ALagrandeur/BOT32/ÉTAT_DU_PROJET.md

# État du projet BOT32

> Photo lisible de l'état du projet. Mise à jour : **2026-10-12**.
> Pour les règles et conventions techniques, voir **`CLAUDE.md`**. Vue d'ensemble
> (matériel, build, utilisation) : **`README.md`** ; UI PC : **`webui/README.md`**.

---

## Version actuelle

**v4.8.1** (principal : v4.8.0 + textes d'aide mis à jour) — dernière version STABLE : **v4.8.0** (validée en voiture le 2026-10-25, release GitHub tag `4.8.0`, point de retour) ; stable précédente : v4.6.0 (tag `v.4.6.0_2_modes`) + **BOT32-HALDEX v3.0.0** (module MITM privé, ESP32-CAN-X2).
**Le X2 de la voiture reste en v3.0.0** (pas de reflash) et **la manette AMOLED n'est pas utilisée** :
seul le principal est flashé, v4.8.0 fonctionne avec ce X2.
Repo public `ALagrandeur/BOT32` (`master`) ; module MITM = dépôt **privé** `BOT32-HALDEX`.
Releases GitHub récentes : **`4.8.0`** (commit `8e49c7f`, 2026-10-25, stable) et `v.4.6.0_2_modes`
(commit `222bdd4`, 2026-10-12).

**Autres appareils liés** : la **manette AMOLED** (dépôt `Remote32`, dossier `Recepteur_AMOLED`,
mode Golf ; **non utilisée actuellement**) parle aussi au X2 par ESP-NOW — elle envoie **SET_MODE seulement** (jamais
SET_PASSTHROUGH). Le X2 a donc deux sources de mode : le principal et la manette.

**Les 3 modes fonctionnent en voiture, confirmés par le pilote.** **STOCK** (normal),
**FWD** (roues avant seulement — le burnout fonctionne), et surtout **50-50 qui TIENT
~95 % d'engagement à TOUTES les vitesses** (le gros morceau enfin résolu). Lien ESP-NOW
solide, contrôle depuis l'UI (modes + passthrough + ack).

### Nouveautés de ce jalon (BOT32-HALDEX v2.0.0 → v3.0.0)
- **50-50 RÉSOLU (le gros morceau).** Découverte clé : le Haldex Gen5 est *feed-forward*
  (piloté par le **couple**, pas le glissement) ET il **réduit l'engagement quand la
  VITESSE monte** — et on lui transmettait la vraie vitesse, donc le lock mourait vers
  60 km/h. Fix : faire croire au Haldex qu'il est **immobile + au ralenti** (vitesse/
  roues/RPM neutralisés côté Haldex) → il ne réduit plus → **95 % tenu à toute vitesse**.
  *(Recette détaillée dans le dépôt privé.)*
- **Angle volant** : seul facteur qui baisse encore le 50-50 — **gardé volontairement**
  (un accouplement 100 % verrouillé bloque la transmission en virage).

### Nouveautés v4.8.1
- Textes d'aide (cellulaire + PC) : l'effacement des codes est un **effacement OBD générique**
  (moteur, et codes antipollution de la boîte DSG) ; « Refus ? Essayer moteur arrêté, contact mis ».
  Aucun autre changement par rapport à la v4.8.0 stable.

### Nouveautés v4.8.0 — 🏁 STABLE (validée en voiture le 2026-10-25)
- **OK maintenu 6 s : plus tolérant + diagnostic.** Premier essai en voiture : rien ne s'est
  déclenché. Un relâchement de moins de 250 ms (trame qui clignote, code qui change) n'annule
  plus l'appui. `/api/status` → `ok_diag` montre ce que BOT32 reçoit pendant l'appui (nombre de
  trames 0x5BF, écart entre trames, durée de l'appui, codes, micro-relâchements, fin du dernier
  maintien : relâché / trame périmée / déclenché).
- **Effacement des codes : OBD générique.** L'envoi direct au moteur (Mode 04 vers 0x7E0, depuis
  v4.6.0) n'effaçait pas les codes dans l'auto. BOT32 envoie maintenant le Mode 04 `[01 04]`
  **OBD générique en adressage fonctionnel sur 0x7DF** (comme un outil OBD générique, sans le mode
  de connexion VW), puis sur **0x700** (adresse de l'outil VW dans `cef.csv`) si le moteur ne
  répond pas. Le moteur décide (0x7E8 : `44` effacé, `78` en attente, autre refus). Comme tout
  effacement OBD générique, la boîte DSG (0x7E9) efface aussi ses codes antipollution ; le message
  l'indique (« Codes effacés : moteur + boîte DSG »).
- **Effacement des codes moteur au volant : bouton OK MAINTENU 6 s** (remplace les 10 appuis
  rapides de v4.7.0). Relâcher avant 6 s annule ; un seul déclenchement par appui (relâcher
  avant le suivant) ; 10 s d'inhibition après un déclenchement. Éviter l'écran des données de
  trajet du combiné : un appui long sur OK les remet à zéro.
- **Haldex remis en STOCK après une longue coupure — par le principal seul, sans reflasher le
  X2.** Le X2 est sur 12 V permanent et sa veille légère garde la mémoire : en v3.0.0 (celui de
  la voiture) le dernier mode survit à une coupure du contact, et **BOT32 est le seul à le
  remettre en STOCK**. Règle (demande du 2026-10-24) :
  - **Coupure de moins de 5 min = mode gardé** : contact coupé puis remis, calage + redémarrage,
    coupure CAN ou radio, redémarrage de BOT32 (chute de tension au démarreur, plantage — BOT32
    reprend alors le mode rapporté par le X2).
  - **Coupure de 5 min ou plus = STOCK.** Coupure = contact OFF (Kl15 lu dans Klemmen_Status_01
    `0x3C0` octet 2 bit 1, confirmé par la capture `1.csv` : `00` → `03` à la mise du contact) ou
    bus cluster silencieux. À 5 min, BOT32 envoie STOCK tout de suite — le X2 est encore éveillé
    (il ne dort qu'après 15 min sans CAN) — et le renvoie à la remise du contact s'il n'a pas été
    confirmé. Seuil : `IGN_LONG_CUT_MS` dans `ignition_watch.h` (5 min ; 10 min possible).
  - **Mise sous tension complète de BOT32** (batterie rebranchée, BOT32 branché) = STOCK : durée de
    coupure inconnue. BOT32 doit être sur alimentation **permanente** (OBD broche 16) pour mesurer la
    coupure ; alimenté par la clé, il donnerait STOCK à chaque démarrage.
  - STOCK est renvoyé toutes les 500 ms **jusqu'à ce que le X2 lui-même le confirme** (normalement
    < 1 s). Si le X2 dort (ESP-NOW coupé), le renvoi continue et le X2 reçoit STOCK environ 1 s
    après son réveil. Abandon seulement après 10 s de liaison sans confirmation, ou 30 min sans
    aucune nouvelle du X2 (absent / pas alimenté).
  - Tous les autres retours en STOCK utilisent le même renvoi confirmé : bouton 🅾 STOCK,
    effacement des codes, TC remis après un combo. Un mode choisi dans l'app ou par combo annule
    le renvoi.
  - Exige la **liaison Haldex activée** dans les réglages de BOT32 (déjà nécessaire pour les combos).
    La désactiver envoie un dernier STOCK confirmé ; ensuite, **plus rien ne remet le X2 en STOCK**
    tant qu'elle reste désactivée. Activée en cours de route (après un démarrage où elle était
    désactivée), la liaison marche tout de suite, sans couper le point d'accès WiFi (avant :
    seulement après un redémarrage de BOT32).
  - Le X2 v3.1.0 (optionnel, non flashé) ajouterait son propre retour en STOCK après 5 s sans CAN,
    ce qui ne respecte pas cette règle : raison de plus pour garder le X2 en v3.0.0.
- **Sortie du combo = le conducteur rallume le TC.** VW rallume le TC tout seul à chaque mise du
  contact : après une courte coupure, le mode combo est gardé et ce TC revenu seul ne le relâche
  pas. Seul un passage TC OFF → ON fait par le conducteur compte (trames TC continues, contact mis,
  tenu 500 ms). Après un redémarrage, pour sortir de FWD/50-50 : **TC OFF puis ON**, ou bouton
  🅾 STOCK. Une trame TC perdue, la coupure du contact ou un redémarrage de l'ESP ne relâchent plus
  le mode (avant : STOCK après 2 s sans trame TC).
- **Combo maintenu malgré une pause de la boucle** (requête web lente, etc.) : la pause fait
  déborder le tampon de réception CAN (32 trames). La fraîcheur des trames du combo se compte en
  temps de lecture CAN (100 ms max par lecture) : une pause ne ressemble jamais à des trames perdues.

### Nouveautés v4.7.0 (déclencheur remplacé en v4.8.0 par « OK maintenu 6 s »)
- **Effacement des codes moteur au volant** : **bouton OK appuyé 10 fois en moins de 6 s**
  (trame MFSW 0x5BF, même décodage que la cellule « OK button » : `byte[0] != 0` = pressé ;
  chaque passage relâché → pressé compte, un appui maintenu compte une fois ; 10 s
  d'inhibition après un déclenchement). Lance exactement la même procédure que le bouton web
  (écoute seule, Haldex STOCK, moteur seulement).
- **Bandeau sur la page principale du cellulaire** (⏳ / ✓ / ✗ + source) seulement si la page
  est ouverte au moment de l'effacement. L'UI PC affiche aussi le résultat, quelle que soit la source.
- Aide-mémoire (cellulaire + PC) : carte « Effacer les codes moteur — OK × 10 en moins de 6 s ».
- ⚠ Le décodage du bouton OK ne distingue pas encore le OK des autres boutons du volant
  (tout `byte[0] != 0` compte). À surveiller ; le code du dernier appui est exposé dans le
  status série (`ok_last_code`) pour l'affiner au besoin.

### Nouveautés v4.6.0
- **Effacement des codes MOTEUR seulement** (bouton web PC + mobile) : BOT32 passe en
  **écoute seule** (aucune émission CAN : ni override du cluster, ni polling OBD), le
  Haldex est remis en **STOCK**, puis Mode 04 est envoyé **au moteur seulement**
  (0x7E0). Le résultat (effacé / refusé / pas de réponse) s'affiche sur la page.
- **50-50 par combinaison** : frein à main tiré + Hazard ON + TC OFF (frein baissé = FWD).
  Un mode armé par le combo ne change plus tant que le TC reste OFF ; TC ON = STOCK.
- **Aide-mémoire des combinaisons** dans l'UI mobile et PC.
- Bouton « Armer / Désarmer le X2 » de la page Réglages mobile réparé (cassé depuis v4.2.0).
- Ancien déclencheur auto Hazard ×3 (jamais codé) retiré de l'UI PC.

### Ajouts principal v4.0.0 → v4.5.0
- **v4.2.0 — Temp embrayage Haldex** : DID UDS **0x2BF1** (poll via le Haldex, à travers
  le pont X2) affichée dans l'UI mobile à la place de « Dernier paquet ». Statut **armé**
  déplacé dans un badge d'en-tête 🟢/🔴 (carte Passthrough retirée ; bouton d'armement
  dans « Tous les réglages »).
- **v4.4.0 — Ménage menu réglages (mobile)** : retiré Cluster bus IDs + Bench test ;
  OBD2 réduit à « Poll Hz » ; « TX » → « Diffusion TX » ; Clear Engine Fault = bouton seul.
- **Voyant shift-lock (0x394) abandonné** : émis par le Gateway + porte le rapport P/R/N/D
  → l'injection parallèle le ferait clignoter / glitcherait l'affichage du rapport. Mode dans l'app.
- **v4.5.0 (FINALE) — Temp embrayage : AFFICHAGE SEULEMENT.** Formule calibrée vs VCDS :
  **`temp_C = data[5]×2.7 − 241.5`** (100→28.5 °C, 104→39.3 °C). **Aucune sécurité/seuil
  côté BOT32** : la **protection thermique native du Haldex** suffit. Le cut-out auto-STOCK
  (ancien v4.3.0) et le raw de calibration (v4.4.0) ont été **retirés** — code épuré.

---

## Module MITM Haldex (BOT32-HALDEX, ESP32-CAN-X2) — résumé technique

- **Topologie en série** : coupe le stub CAN du calculateur Haldex. CAN1 = TWAI natif
  (côté CAR/PCM, GPIO7/6) ; CAN2 = MCP2515 sur HSPI (côté Haldex).
- **Pont CAR ↔ Haldex** dans une **tâche FreeRTOS dédiée** démarrée AVANT le WiFi →
  écart de boot minimal (évite les défauts TC/TPMS au démarrage en série).
- **CRC E2E AUTOSAR** (poly 0x2F, init 0xFF, xorout 0xFF) sur `[D2..D8, DataID]` —
  **DataID APPENDÉ** (confirmé 100 % sur 5 logs réels). Compteur = `D2 & 0x0F`.
- **Réécriture des trames** (FWD inchangé, ça marche) : **FWD** → demande 0x00 + roues
  à 0. **50-50** → épingle le couple + plafond ET fait croire au Haldex qu'il est
  **immobile + au ralenti** (vitesse/roues/RPM neutralisés côté Haldex) pour qu'il ne
  réduise pas l'engagement à vitesse. Le **frein n'est PAS simulé** (freiner-en-roulant
  = 0 % d'engagement, le simuler tuerait le lock). *(Valeurs exactes + table CRC : privé.)*
- **État live lu** : engagement pompe (0x118 D3), pédale (0x121 D3), vitesse (0x0FD).
- **12 V permanent + light-sleep** (15 min d'inactivité CAN) + **wake-on-CAN** ;
  **ne dort jamais** tant qu'un hôte USB est branché (`if (Serial)`).
- **Robustesse CAN** : récupération bus-off TWAI **et** MCP2515 (re-init sur EFLG TXBO),
  exposition du **TEC**. Terminaison **TERM2 (120 Ω)** activée côté Haldex.
- **Persistance** : le passthrough est **persisté en NVS** ; le **mode boot TOUJOURS STOCK**
  (sécurité — rien ne s'active tout seul au démarrage du X2). ⚠ Le X2 ne redémarre pas avec
  l'auto (12 V permanent, la veille garde la RAM) : en v3.0.0 le mode survit à un cycle de
  contact ; c'est BOT32 v4.8.0 (liaison Haldex activée) qui le remet en STOCK après une coupure de 5 min ou plus.

---

## Haldex — logique côté principal

- **Lien ESP-NOW uniquement.** AP téléphone + ESP-NOW **coexistent** sur le **canal 1**
  (mode AP+STA quand le lien est activé). Le PC en **USB-C** peut aussi parler
  directement au X2 (dev/diagnostic) — ESP-NOW court-circuité dans ce mode.
- **2e source de mode : la manette AMOLED** (Remote32, mode Golf ; non utilisée actuellement) écoute le STATE et envoie
  SET_MODE (STOCK/FWD/50-50) ; elle ne peut pas armer. Le principal affiche le **mode
  rapporté par le X2** et renvoie toujours un STOCK explicite quand on appuie sur STOCK.
- **3 modes** : STOCK / FWD / 50-50.
- **FWD** = combo **Hazards ON + TC OFF** (ou app) ; **v3.10.0 : sort quand le TC repasse à ON** (plus quand les warnings s'éteignent → on peut couper les Hazards et garder FWD).
  **50-50** = **v4.6.0 : même combo avec le frein à main tiré** au moment où il se complète (frein baissé = FWD) ; un mode armé par le combo sort quand le TC repasse à ON. Aussi par l'app/USB (sort via STOCK). **Pas d'auto-revert. Pas de seuil de pédale.**
- **Passthrough ON/OFF** (commande live, **depuis l'app du principal seulement**) : ON =
  transparent/sûr ; OFF = MITM **armé**. Le X2 **persiste le passthrough en NVS** (il revient
  dans l'état où il a été laissé ; 1er boot = ON) ; c'est le **mode** qui démarre toujours en
  **STOCK**, donc rien n'est modifié tant qu'un mode n'est pas choisi. Affiché en live +
  confirmation modale avant d'armer + **ack** du X2 dans l'UI.
- **LIVE** : Vitesse · Pédale % · Lock target % · Pump % · Mode · Connexion (bandeau) · Passthrough
  · temp embrayage (0x2BF1, UI mobile). La **santé CAN du X2 (rx/tx✗/TEC/EFLG)** n'est **pas** dans le
  paquet STATE ESP-NOW : elle ne s'affiche que dans l'UI PC en mode **USB-C direct au X2**.
  Boutons mode + armement aussi sur l'**UI mobile**.

---

## Ce qui fonctionne (livré)

- ✅ **Boost-on-coolant** : override de Motor_09 (0x647), mapping linéaire MAP→température.
- ✅ **Polling UDS multi-DID** (round-robin 6 slots) : MAP, éthanol, blocage Haldex, huile DSG, EGT, **temp embrayage Haldex (0x2BF1)**.
- ✅ **4 sniffers passifs** (lecture seule) : frein à main, bouton OK volant, Hazard, Traction Control — Hazard + TC + frein à main servent aussi d'entrées aux combos Haldex.
- ✅ **Effacement codes moteur** (v4.6.0) : écoute seule + Haldex STOCK + Mode 04 vers 0x7E0 — bouton web PC + mobile.
- ⚠️ **Clear DTC tous modules** : la machine à états UDS non bloquante (14 ECU) existe dans le
  firmware, mais **seulement comme commande série** `{"cmd":"clear_all_dtcs"}` — **aucun bouton
  UI** (PC ou mobile). Sa liste contient `0x715`, que `docs/future_features.md` désigne comme
  l'Airbag à ne jamais effacer (à confirmer). Fonction héritée — statut à décider.
- ✅ **Bench test mode** + **lamp killer** (cartographie des voyants du combiné).
- ✅ **UI web PC** (Flask + SocketIO) via USB série + **UI mobile** via WiFi AP (PROGMEM).
- ✅ **MITM Haldex confirmé EN VOITURE** : STOCK / FWD (avant seulement) / 50-50, lien
  ESP-NOW solide, contrôle depuis l'UI. Firmware dans le dépôt **privé** `BOT32-HALDEX`
  (carte Autosport Labs **ESP32-CAN-X2**).
- ✅ **Sécurité** : `block_airbag` forcé ON, 5 s sans émission sur le bus combiné au boot (le
  polling UDS sur le bus OBD2, lui, démarre dès le boot avec les réglages par défaut), confirmations modales,
  aucun ID deviné émis par défaut, mode boot TOUJOURS STOCK, série USB toujours active.

---

## Historique des versions (résumé)

### Principal (BOT32)
| Version | Apport principal |
|---|---|
| v2.x | Voir historique antérieur (UDS multi-DID, WiFi AP, sniffers, bench mode) |
| v3.0.0 | Version stable — toutes les fonctions confirmées sur banc |
| v3.1.0 | **Haldex** : lien ESP-NOW, 3 modes, combo FWD, UI PC+mobile, coexistence canal 1 |
| v3.2.0 | Transport CAN mort retiré (ESP-NOW only) |
| v3.3.0 | Mode/passthrough persistés + UI affiche le mode réel du X2 |
| v3.4.0 | Lamp killer (test voyants au banc, trames live depuis l'UI) |
| v3.7.0 | Source de lien Haldex sélectionnable (ESP-NOW / USB-C direct vers le X2) |
| v3.8.0 | **Verrou de canal ESP-NOW explicite** côté principal + compteur RX + bandeau de lien dans l'UI |
| v3.9.0 | **Power-save WiFi OFF** (lien ESP-NOW fiable) + lecture du canal réel |
| v3.10.0 | **FWD sort quand le TC repasse à ON** (plus quand Hazards OFF) — état TC latché |
| **v4.0.0** | 🏁 **Jalon stable** — tout confirmé en voiture (STOCK/FWD/50-50, lien solide, UI complète) |
| v4.1.0 | Libellés des sources CAN sous les cellules Haldex + finitions de l'UI mobile (dernière release GitHub) |
| v4.2.0 | Temp embrayage Haldex (DID 0x2BF1) dans l'UI mobile + badge d'armement 🟢/🔴 |
| v4.3.0 | Limite de temp embrayage + coupure auto vers STOCK (retirée en v4.5.0) |
| v4.4.0 | Ménage de la page Réglages mobile + valeur brute 0x2BF1 pour la calibration |
| **v4.5.0** | 🏁 Temp embrayage **affichage seulement** (formule calibrée vs VCDS), coupure retirée — version stable précédente |
| **v4.6.0** | 🏁 Stable précédente — Effacement codes moteur en écoute seule, 50-50 par combo (frein à main), aide-mémoire — confirmée en voiture (2026-10-12) |
| v4.7.0 | Effacement des codes moteur au volant (OK × 10 en < 6 s) + bandeau de confirmation sur le cellulaire — jamais validée, remplacée par v4.8.0 |
| v4.8.0 | Haldex remis en STOCK après une coupure de 5 min ou plus (coupure plus courte : mode gardé), renvoyé jusqu'à confirmation du X2 — fonctionne avec le X2 v3.0.0, sans reflash (liaison Haldex activée) ; sortie du combo par le conducteur (TC OFF → ON) ; effacement des codes au volant par **OK maintenu 6 s** ; effacement en Mode 04 OBD générique (0x7DF, puis 0x700) — 🏁 **STABLE, validée en voiture (2026-10-25)**, release `4.8.0` |
| v4.8.1 | Textes d'aide : effacement OBD générique (moteur + boîte DSG) |

### Module MITM (BOT32-HALDEX)
| Version | Apport principal |
|---|---|
| v0.3–0.4 | Persistance état + spoof vitesses de roue (FWD) |
| v0.7.x | **CRC E2E corrigé** (DataID appendé) + 0x116=0xAC / 0x106=0x07 + 50-50 demande 0xFA |
| v1.1.0 | Jeu de trames complet (0x116/0x106/0x0B2) sur FWD ET 50-50, sans seuil pédale |
| v1.3.0 | Pont en **tâche FreeRTOS avant WiFi** (fix défauts TC/TPMS au boot) |
| v1.4.x | **12 V permanent** + light-sleep 15 min + wake-on-CAN + récup bus-off MCP/TWAI + TEC |
| v1.5.0 | **Power-save WiFi OFF** + diagnostics ESP-NOW (canal/tx/rxcmd) |
| v1.6.0 | **Fix 50-50** : 0x0A8 en passthrough (D8 = RPM, pas la demande de lock) |
| **v2.0.0** | 🏁 **Jalon stable** — MITM confirmé en voiture (STOCK/FWD/50-50), lien ESP-NOW solide |
| **v3.0.0** | 🏁 **Jalon stable actuel — dans la voiture** — 50-50 tenu ~95 % à toutes les vitesses, confirmé en voiture (détails dans le dépôt privé) |
| v3.1.0 | **Optionnel, non flashé** — STOCK après 5 s sans CAN et avant la veille + correctif du minuteur de veille. Le X2 de la voiture reste en v3.0.0 |

---

## Pistes / roadmap (à faire — captures en attente)

- *(Probablement obsolète depuis X2 v3.0.0, où le 50-50 tient ~95 % à toutes les vitesses — à confirmer.)*
  📌 **Log Haldex 50-50 en roulant** (côté Haldex) : confirmer que l'engagement (0x118)
  tient sous charge, et tester **0x116** haut/bas/off (seul octet ESP incertain). Comparer
  à un run STOCK. → décide s'il faut affiner le 50-50.
- 📌 **Log cluster voyant** : capturer les **2 payloads** (allumé + éteint) d'un témoin pour
  pouvoir le faire clignoter (indicateur FWD au combiné — la trame « éteinte » manquait).
- ✅ **v4.8.0 validée en voiture le 2026-10-25** (« tout semble fonctionnel ») : règle des 5 min, effacement OBD générique, OK maintenu 6 s. Release GitHub `4.8.0`.
- 💡 Web UI pour les boutons du volant (objectif initial du projet).

---

## Notes de reprise

- Lancer Claude Code depuis `C:\Users\AntoineLagrandeur\MK7-cluster` pour recharger la
  **mémoire auto** ; le code principal est dans `C:\Users\AntoineLagrandeur\BOT32`,
  le module MITM dans `C:\Users\AntoineLagrandeur\BOT32-HALDEX`.
- **Réglages Arduino X2** : carte « ESP32S3 Dev Module », **USB CDC On Boot = Enabled**
  (le port USB-C est l'USB natif de l'ESP32-S3 ; sinon le moniteur série reste muet).
- **ESP-NOW** : les deux ESP32 doivent être sur le **canal 1** (verrouillé) et avec le
  **power-save OFF** (fait en v3.9.0 / v1.5.0). Vérif : bandeau vert dans l'UI, ou
  ligne `[5s]` du X2 `espnow ch=1 tx=… rxcmd=…`.
- **Sur banc** : garder le **X2 sur USB-C** (sinon sommeil après 15 min → ESP-NOW coupé).
- **Jalon v4.0.0 / v2.0.0 (2026-06-06)** : version **stable**, tout confirmé en voiture par le
  pilote. Inclut le fix FWD-sort-sur-TC (v3.10.0) et le fix 50-50 0x0A8 (v1.6.0). Prochaines
  étapes = les 2 captures en attente (log Haldex 50-50 + log cluster voyant).
