ALagrandeur/BOT32/Cluster Bench.png

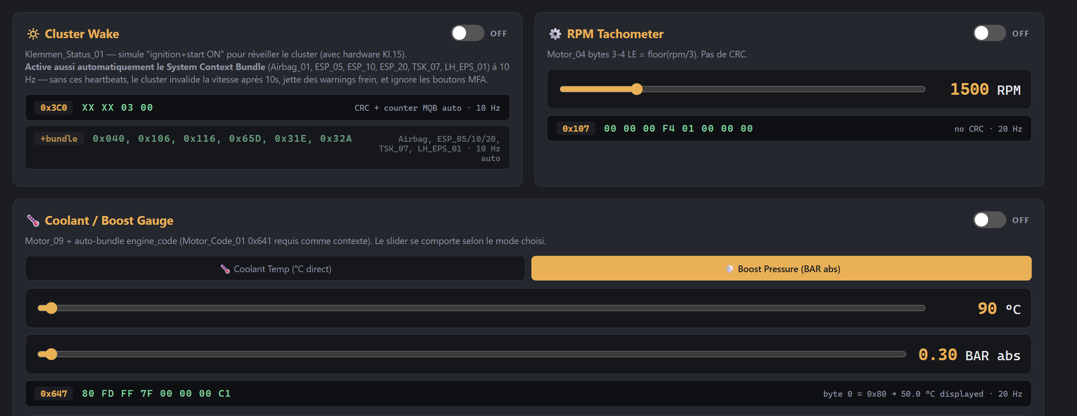
Cluster Bench.png
