ALagrandeur/BOT32/ESP32.jpg

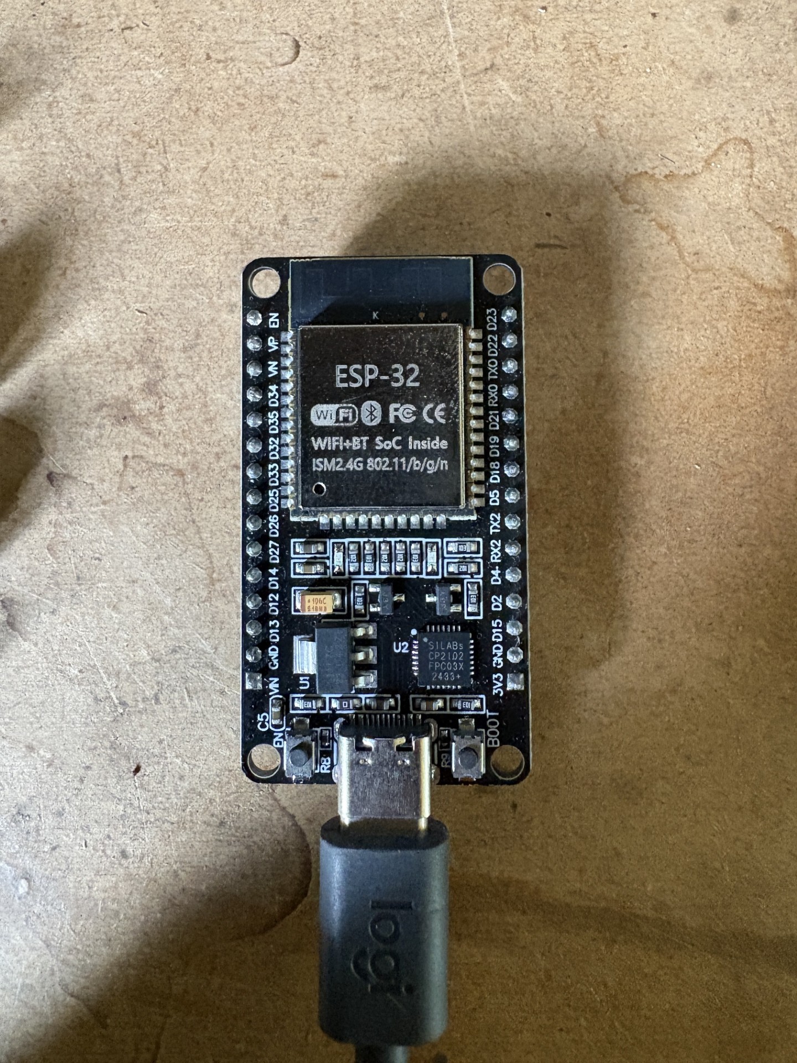
ESP32.jpg
