ALagrandeur/BOT32/HAT.jpg

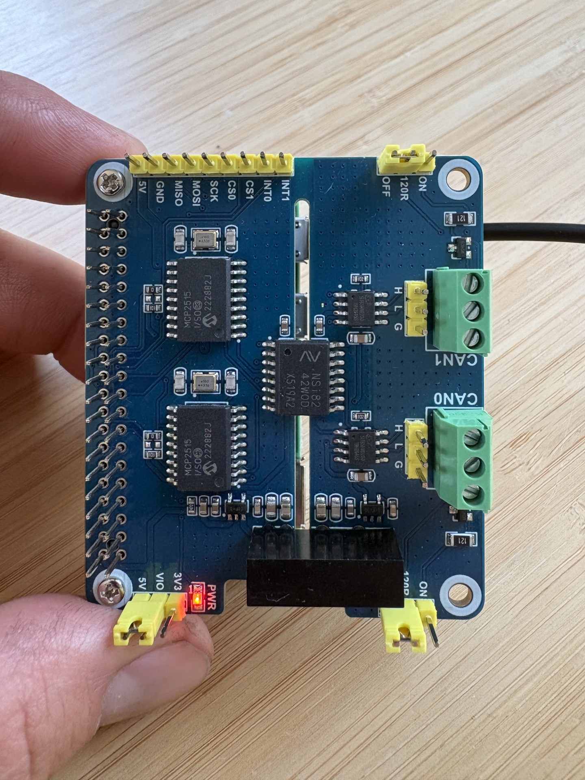
HAT.jpg
