ALagrandeur/BOT32/BOT32/haldex_modes.cpp

/*
 * haldex_modes.cpp — main-side Haldex mode decision logic (v3.1.0).
 *
 * Decides the active mode (STOCK/FWD/5050) from two sources and pushes it to
 * the external MITM (ESP32-CAN-X2) via the ESP-NOW link:
 *
 *   - FWD  : PHYSICAL combo = Hazards ON + Traction-Control OFF, detected via
 *            the existing cluster sniffers. v3.10.0: exits (-> STOCK) when
 *            traction control is turned back ON (NOT when the hazards go off),
 *            so the hazards can be switched off while FWD stays armed. Also
 *            settable from app/USB.
 *   - 5050 : v4.6.0: same combo with the HAND BRAKE PULLED at the moment the
 *            combo completes (else FWD); exits like FWD (TC back ON). Also
 *            app/USB button, which exits via the app/USB STOCK button.
 *   - STOCK: default; app/USB button; or TC-back-ON after a combo FWD.
 *
 * v4.8.0 — a cut shorter than 5 min (key off/on, stall + restart, CAN or radio
 * drop-out, BOT32 reset) keeps the X2 mode; STOCK after a cut of 5 min or more
 * comes from ignition_watch. So a combo mode is only released by the DRIVER
 * turning TC back ON: a TC OFF -> ON change in a continuous TC frame stream,
 * ignition ON, held 500 ms. A lost TC frame, the ignition being cut, or the TC
 * that comes back ON by itself after a restart no longer release it.
 *
 * NOTE on "TC OFF": confirmed on the live data that ESP_21 (0x0FD) byte6 == 0x03
 * is the LATCHED "traction control disabled" state — it stays set after the
 * button is released, and clears (0x00) when TC is re-enabled. So we use it as
 * BOTH the arming gesture (with hazards ON) and the FWD hold/release condition:
 * FWD is held while TC is OFF and released when TC is turned back ON.
 *
 * No timed auto-revert (a timed mechanical revert was judged too dangerous).
 */
#include "haldex_modes.h"
#include "button_sniffer.h"
#include "haldex_link.h"
#include "settings.h"
#include "config.h"
#include "can_handler.h"

#define COMBO_FRESH_MS    2000   // sniffer values older than this are ignored
#define COMBO_POLL_STEP_MS 100   // v4.8.0: max polled time one can_poll() can add
#define TC_ON_CONFIRM_MS   500   // v4.8.0: TC back ON must hold this long to release a combo
#define TC_STREAM_GAP_MS   200   // v4.8.0: no TC frame for this long = stream broken (0x0FD every 20 ms)
#define KL15_FRESH_MS     1000   // v4.8.0: 0x3C0 is sent every 100 ms
#define TELLTALE_BLINK_MS 500    // 0.5 s blink phase while non-STOCK

static uint8_t  g_mode          = HALDEX_M_STOCK;
static bool     g_mode_from_combo = false;  // FWD/50-50 currently held by the combo
static bool     g_prev_combo     = false;   // rising-edge detector
static bool     g_telltale_phase = false;
static uint32_t g_last_blink_ms  = 0;
static bool     g_passthrough_desired = true;  // safe default (X2 boots ON too)
// v4.8.0 — forced STOCK (see haldex_modes_force_stock). The X2 v3.0.0 in the
// car never goes back to STOCK on its own, so STOCK is re-sent until the X2
// itself reports it, including while the X2 sleeps (ESP-NOW down until it wakes).
#define FORCE_STOCK_RESEND_MS    500       // re-send period
#define FORCE_STOCK_WINDOW_MS  10000       // give up after 10 s of X2 link without STOCK
#define FORCE_STOCK_MAX_MS   1800000UL     // ... or 30 min without ever hearing the X2
static bool     g_force_pending   = false;
static bool     g_force_link_off  = false;  // started by switching the link OFF
static uint32_t g_force_start_ms  = 0;
static uint32_t g_force_next_ms   = 0;
static uint32_t g_force_last_ms   = 0;      // last force_stock_tick() time
static uint32_t g_force_online_ms = 0;      // X2 link time since the force started
static bool     g_prev_enabled    = false;  // haldex_enabled at the previous tick
// v4.8.0 — polled time since each combo frame was last seen (see track_frame)
static uint32_t g_prev_poll_ms   = 0;
static uint32_t g_hz_missed_ms   = COMBO_FRESH_MS;
static uint32_t g_tc_missed_ms   = COMBO_FRESH_MS;
static uint32_t g_hb_missed_ms   = COMBO_FRESH_MS;
static uint32_t g_kl_missed_ms   = KL15_FRESH_MS;
// v4.8.0 — combo release by the driver (see header) and resync after a BOT32 reset
static bool     g_tc_seen_off    = false;  // TC seen OFF in the current stream, ignition ON
static bool     g_tc_on_timing   = false;  // TC back ON, confirming
static uint32_t g_tc_on_ms       = 0;
static bool     g_force_confirmed = false; // last forced STOCK was confirmed by the X2
static bool     g_resync         = true;   // adopt the X2 mode once (BOT32 reset, X2 kept its mode)

void haldex_modes_init() {
  g_mode           = HALDEX_M_STOCK;
  g_mode_from_combo = false;
  g_prev_combo     = false;
  g_telltale_phase = false;
  g_last_blink_ms  = 0;
  g_passthrough_desired = true;
  g_force_pending  = false;
  g_force_link_off = false;
  g_prev_enabled   = settings_get().haldex_enabled;
  g_prev_poll_ms   = 0;
  g_hz_missed_ms   = COMBO_FRESH_MS;
  g_tc_missed_ms   = COMBO_FRESH_MS;
  g_hb_missed_ms   = COMBO_FRESH_MS;
  g_kl_missed_ms   = KL15_FRESH_MS;
  g_tc_seen_off    = false;
  g_tc_on_timing   = false;
  g_force_confirmed = false;
  g_resync         = true;
}

// Internal: change mode + forward to the MITM if it actually changed.
static void apply_mode(uint8_t mode) {
  if (mode > HALDEX_M_5050) mode = HALDEX_M_5050;
  if (mode != HALDEX_M_STOCK) g_force_pending = false;   // driver chose a mode
  if (mode == g_mode) return;
  g_mode = mode;
  haldex_link_set_mode(g_mode);   // ESP-NOW SET_MODE to the X2
  Serial.print("[haldex_modes] mode -> ");
  Serial.println(g_mode);
}

// Internal: STOCK now + re-sent by force_stock_tick() until the X2 reports it.
static void force_stock_start(const char* reason, bool link_off) {
  uint32_t now = millis();
  g_mode_from_combo = false;
  apply_mode(HALDEX_M_STOCK);
  haldex_link_send_forced_stock(true);        // always (re)send, even if g_mode was STOCK
  g_force_pending   = true;
  g_force_link_off  = link_off;
  g_force_start_ms  = now;
  g_force_next_ms   = now + FORCE_STOCK_RESEND_MS;
  g_force_last_ms   = now;
  g_force_online_ms = 0;
  g_force_confirmed = false;
  g_resync          = false;
  Serial.print("[haldex_modes] forced STOCK: ");
  Serial.println(reason ? reason : "");
}

bool haldex_modes_set_manual(uint8_t mode) {
  const Settings& s = settings_get();
  if (!s.haldex_enabled) return false;
  if (mode > HALDEX_M_5050) return false;

  // v4.8.0: an explicit STOCK (app, USB, engine-code clear) is always (re)sent
  // and re-sent until the X2 confirms it — the X2 may still be in FWD/50-50
  // while g_mode already reads STOCK (lost broadcast, BOT32 rebooted, USB-C dev link).
  if (mode == HALDEX_M_STOCK) {
    force_stock_start("commande STOCK", false);
    return true;
  }
  // Manual command clears the combo latch so the two sources don't fight.
  g_mode_from_combo = false;
  apply_mode(mode);
  return true;
}

void haldex_modes_force_stock(const char* reason) {
  const Settings& s = settings_get();
  if (!s.haldex_enabled) return;
  force_stock_start(reason, false);
}

bool haldex_modes_force_stock_pending() { return g_force_pending; }
bool haldex_modes_force_stock_confirmed() { return g_force_confirmed; }

// v4.8.0 — combo frames go stale on POLLED time, not wall time. After a long
// stall elsewhere in loop() (e.g. a blocked HTTP request) the 32-frame MCP2515
// RX buffer has overflowed and the first can_poll() may hold no TC frame at
// all; that poll adds at most COMBO_POLL_STEP_MS, so the last decoded value is
// kept until normal polling has missed the frame for COMBO_FRESH_MS. A real bus
// loss (polls continue, no frames) still goes stale after COMBO_FRESH_MS.
static bool seen_at_last_poll(uint32_t age_now) {
  if (age_now == UINT32_MAX) return false;
  int32_t since_poll = (int32_t)(millis() - can_last_poll_ms());
  return age_now <= (since_poll < 0 ? 0u : (uint32_t)since_poll);
}

static void track_frame(uint32_t& missed_ms, uint32_t age_now, uint32_t step) {
  if (seen_at_last_poll(age_now))     missed_ms = 0;
  else if (missed_ms < COMBO_FRESH_MS) missed_ms += step;
}

static void track_combo_frames() {
  uint32_t poll = can_last_poll_ms();
  uint32_t step = 0;
  if (g_prev_poll_ms != 0) {
    int32_t d = (int32_t)(poll - g_prev_poll_ms);
    step = d <= 0 ? 0 : (d > COMBO_POLL_STEP_MS ? COMBO_POLL_STEP_MS : (uint32_t)d);
  }
  g_prev_poll_ms = poll;
  track_frame(g_hz_missed_ms, button_sniffer_hazard_age_ms(),    step);
  track_frame(g_tc_missed_ms, button_sniffer_tc_age_ms(),        step);
  track_frame(g_hb_missed_ms, button_sniffer_handbrake_age_ms(), step);
  track_frame(g_kl_missed_ms, button_sniffer_ignition_age_ms(),  step);
}

// Ignition ON for the TC-release rule (polled time, like the combo frames).
// Klemmen_Status_01 never seen since boot -> assumed ON (no gating possible).
static bool ignition_on_now() {
  if (button_sniffer_ignition_age_ms() == UINT32_MAX) return true;
  return button_sniffer_ignition_on() && g_kl_missed_ms < KL15_FRESH_MS;
}

// True once when the driver turns TC back ON (see header). Tracks the TC OFF
// state in a continuous frame stream with the ignition ON.
static bool tc_turned_back_on(uint32_t now) {
  if (!ignition_on_now() || g_tc_missed_ms >= TC_STREAM_GAP_MS) {
    g_tc_seen_off  = false;              // cut / restart / lost frames: start over
    g_tc_on_timing = false;
    return false;
  }
  if (button_sniffer_tc_pressed()) {     // 0x0FD byte6 == 0x03: TC OFF
    g_tc_seen_off  = true;
    g_tc_on_timing = false;
    return false;
  }
  if (!g_tc_seen_off) return false;      // ON with no OFF seen first (e.g. after a restart)
  if (!g_tc_on_timing) { g_tc_on_timing = true; g_tc_on_ms = now; return false; }
  if ((int32_t)(now - g_tc_on_ms) < (int32_t)TC_ON_CONFIRM_MS) return false;
  g_tc_seen_off  = false;
  g_tc_on_timing = false;
  return true;
}

// After a BOT32 reset that is not a full power-up, the X2 kept its mode: adopt
// it once (first X2 STATE after boot) so the TC / STOCK exits still work. Taken
// as a combo mode, so turning TC OFF then ON again releases it too.
static void resync_from_x2() {
  if (!g_resync) return;
  if (g_force_pending || g_mode != HALDEX_M_STOCK) { g_resync = false; return; }
  HaldexState hx = haldex_link_get_state();
  if (!hx.valid || (uint32_t)(millis() - hx.last_rx_ms) >= HALDEX_LINK_STALE_MS) return;
  g_resync = false;
  if (hx.current_mode == HALDEX_M_STOCK || hx.current_mode > HALDEX_M_5050) return;
  g_mode = hx.current_mode;                // no send: the X2 is already in this mode
  g_mode_from_combo = true;
  Serial.print("[haldex_modes] mode repris du X2 -> ");
  Serial.println(g_mode);
}

static void force_stock_tick(uint32_t now) {
  if (!g_force_pending) return;
  int32_t dt = (int32_t)(now - g_force_last_ms);
  if (dt > 0) g_force_last_ms = now; else dt = 0;
  HaldexState hx = haldex_link_get_state();
  uint32_t age = millis() - hx.last_rx_ms;   // from the snapshot (STATE comes from the WiFi task)
  bool x2_online = hx.valid && age < HALDEX_LINK_STALE_MS;
  if (x2_online) g_force_online_ms += (uint32_t)dt;
  int32_t since = (int32_t)(now - g_force_start_ms);
  // Only a STATE received after the force started proves STOCK: an older one
  // (radio drop-out right after a FWD command) may predate the change.
  if (x2_online && hx.current_mode == HALDEX_M_STOCK &&
      (int32_t)(hx.last_rx_ms - g_force_start_ms) > 0 &&
      since >= (int32_t)FORCE_STOCK_RESEND_MS) {
    g_force_pending   = false;                 // X2 confirmed STOCK
    g_force_confirmed = true;
    Serial.println("[haldex_modes] X2 confirmed STOCK");
    return;
  }
  // Give up: link switched OFF -> 10 s; otherwise 10 s of X2 link without a
  // STOCK report, or 30 min without ever hearing the X2 (missing / unpowered).
  // While the X2 sleeps the re-send keeps going, so it gets STOCK on waking.
  bool give_up = g_force_link_off
      ? since >= (int32_t)FORCE_STOCK_WINDOW_MS
      : (g_force_online_ms >= FORCE_STOCK_WINDOW_MS || since >= (int32_t)FORCE_STOCK_MAX_MS);
  if (give_up) {
    g_force_pending = false;
    Serial.println("[haldex_modes] forced STOCK not confirmed by the X2 - giving up");
    return;
  }
  if ((int32_t)(now - g_force_next_ms) >= 0) {
    haldex_link_send_forced_stock(false);
    g_force_next_ms = now + FORCE_STOCK_RESEND_MS;
  }
}

void haldex_modes_tick(uint32_t now) {
  const Settings& s = settings_get();

  force_stock_tick(now);
  track_combo_frames();

  if (!s.haldex_enabled) {
    // v4.8.0: switching the link OFF sends a last STOCK, re-sent until the X2
    // confirms it (10 s max) — otherwise an X2 v3.0.0 left in FWD / 50-50 would
    // keep that mode at every restart, BOT32 no longer talking to it.
    if (g_prev_enabled) force_stock_start("liaison Haldex desactivee", true);
    g_prev_enabled = false;
    if (!g_force_link_off) g_force_pending = false;
    // Link disabled: force STOCK once and do nothing else.
    if (g_mode != HALDEX_M_STOCK) apply_mode(HALDEX_M_STOCK);
    g_mode_from_combo = false;
    g_prev_combo = false;
    g_telltale_phase = false;
    return;
  }
  g_prev_enabled   = true;
  g_force_link_off = false;   // link back ON: a pending STOCK follows the normal rules

  resync_from_x2();
  bool tc_back_on = tc_turned_back_on(now);

  // ---- Physical combo: Hazards ON + TC OFF (both fresh) ----
  // button_sniffer_tc_pressed() == the LATCHED traction-control-disabled state
  // (0x0FD byte6==0x03 stays set while TC is off), so tc_off is a stable signal.
  bool hazard_on = button_sniffer_hazard_active() && g_hz_missed_ms < COMBO_FRESH_MS;
  bool tc_off    = button_sniffer_tc_pressed()    && g_tc_missed_ms < COMBO_FRESH_MS;
  bool combo     = hazard_on && tc_off;

  // Rising edge of the combo arms FWD, or 50/50 if the hand brake is pulled at
  // that instant (KOMBI_01 0x30B, vehicle-confirmed). Only arms from a
  // non-combo state: once a combo mode is held, re-pressing the hazards (or a
  // stale 0x366 frame coming back) never switches FWD <-> 50/50 while TC is
  // still OFF. To change, turn TC back ON (-> STOCK) and redo the combo.
  // Hazards ON is the deliberate gate, so disabling TC alone never arms anything.
  if (combo && !g_prev_combo && !g_mode_from_combo) {
    bool hb_on = button_sniffer_handbrake_active() && g_hb_missed_ms < COMBO_FRESH_MS;
    g_mode_from_combo = true;
    apply_mode(hb_on ? HALDEX_M_5050 : HALDEX_M_FWD);
  }
  g_prev_combo = combo;

  // v3.10.0: TC turned back ON releases a combo-armed mode (FWD or 50/50) back to STOCK (was
  // "hazards OFF"). So the hazards can be switched off while FWD stays armed;
  // FWD drops only when traction control is re-enabled.
  // v4.8.0: only the driver turning TC back ON counts (tc_turned_back_on): a
  // lost TC frame or a short cut keeps the mode. Re-sent until the X2 confirms.
  if (g_mode_from_combo && tc_back_on) {
    force_stock_start("TC reactive", false);
  }

  // ---- Telltale blink phase (exposed only; no CAN emit here) ----
  if (g_mode == HALDEX_M_STOCK) {
    g_telltale_phase = false;
  } else if (now - g_last_blink_ms >= TELLTALE_BLINK_MS) {
    g_telltale_phase = !g_telltale_phase;
    g_last_blink_ms = now;
  }
}

uint8_t haldex_modes_get()          { return g_mode; }
bool    haldex_modes_telltale_on()  { return g_telltale_phase; }

bool haldex_modes_set_passthrough(bool passthrough) {
  const Settings& s = settings_get();
  if (!s.haldex_enabled) return false;
  bool ok = haldex_link_set_passthrough(passthrough);
  if (ok) g_passthrough_desired = passthrough;
  return ok;
}

bool haldex_modes_get_passthrough_desired() { return g_passthrough_desired; }
