ALagrandeur/BOT32/BOT32/haldex_modes.h

/*
 * haldex_modes.h — BOT32 main-side Haldex mode logic (v3.1.0)
 *
 * This module decides WHICH Haldex mode is active and pushes it to the
 * external MITM device (the ESP32-CAN-X2 running BOT32-HALDEX) via the
 * ESP-NOW link (haldex_link_set_mode).
 *
 * Mode sources (per user spec):
 *   - FWD  : armed by a PHYSICAL combo — Hazards ON + Traction Control OFF
 *            (detected by the existing cluster sniffers), OR by the app/USB
 *            button. v3.10.0: it EXITS (back to STOCK) when Traction Control is
 *            turned back ON (NOT when the hazards go off) — so the hazards can
 *            be switched off while FWD stays armed.
 *   - 5050 : v4.6.0: same physical combo with the HAND BRAKE PULLED when it
 *            completes (else FWD) — exits like FWD (TC back ON). Also the
 *            app/USB button, which EXITS via the app/USB STOCK button.
 *   - STOCK: default; app/USB button.
 *
 * There is NO timed auto-revert (a timed mechanical revert was judged too
 * dangerous). Exit is always an explicit driver action.
 *
 * Telltale feedback: while a non-STOCK mode is active, the user wants the
 * hand-brake telltale to blink on the cluster. NOTE: this car has a MANUAL
 * hand brake whose telltale is driven by a hard-wired switch, NOT by a CAN
 * input frame — so blinking it via CAN is uncertain (bench-only at best).
 * This module therefore only EXPOSES the desired blink state
 * (haldex_modes_telltale_on()); it does NOT emit any guessed CAN frame by
 * default (honours the project safety rule). The actual telltale TX is a
 * separate, to-be-confirmed step (jalon 3).
 */
#ifndef BOT32_HALDEX_MODES_H
#define BOT32_HALDEX_MODES_H

#include <Arduino.h>

// Mode numbers (subset of the documented convention; only 3 are supported).
#define HALDEX_M_STOCK 0
#define HALDEX_M_FWD   1
#define HALDEX_M_5050  2

void    haldex_modes_init();

// Call every loop. Runs the Hazard+TC combo state machine and (re)sends the
// effective mode to the MITM whenever it changes.
void    haldex_modes_tick(uint32_t now);

// Manual mode request from the app / USB (0=STOCK, 1=FWD, 2=5050).
// Clears the physical-combo latch so the two sources don't fight.
// Returns true if the command was accepted + forwarded to the MITM.
bool    haldex_modes_set_manual(uint8_t mode);

// v4.8.0 — force STOCK (vehicle cut for 5 min or more, BOT32 power-up — see
// ignition_watch). Clears the combo latch, sends STOCK now and keeps re-sending it every
// 500 ms until the X2 reports STOCK — also while the X2 sleeps (it gets STOCK
// as soon as it wakes). Gives up after 10 s of X2 link without a STOCK report,
// or 30 min without hearing the X2 at all. Every other STOCK (app/USB button,
// engine-code clear, TC back ON after a combo, link switched OFF) uses the same
// re-send. A mode chosen afterwards from the app or a combo cancels the re-send;
// a mode sent by the AMOLED remote (which BOT32 does not see) is only safe once
// the X2 has confirmed STOCK (normally < 1 s). No-op if Haldex disabled.
void    haldex_modes_force_stock(const char* reason);
bool    haldex_modes_force_stock_pending();
bool    haldex_modes_force_stock_confirmed();   // the last forced STOCK was confirmed by the X2

// Current effective mode (0/1/2) as decided by this module.
uint8_t haldex_modes_get();

// True while the desired telltale-blink phase is "on" (for a future cluster
// TX and for UI indication). Toggles at ~0.5 s while a non-STOCK mode is
// active; always false in STOCK.
bool    haldex_modes_telltale_on();

// v3.2.0 — passthrough control (sent to the X2 over ESP-NOW).
//   passthrough=true  -> X2 is a transparent bridge (safe; nothing modified).
//   passthrough=false -> X2 arms the MITM (FWD/5050 actually force the lock).
// The X2 always BOOTS in passthrough=ON; this is the desired value pushed by
// the user. Returns true if the command was accepted + forwarded.
bool    haldex_modes_set_passthrough(bool passthrough);

// Last passthrough value we COMMANDED (desired). The ACTUAL value reported by
// the X2 comes from the STATE packet (HaldexState.passthrough).
bool    haldex_modes_get_passthrough_desired();

#endif // BOT32_HALDEX_MODES_H
