ALagrandeur/BOT32/BOT32/wifi_ui.cpp

/*
 * wifi_ui.cpp — implementation
 */
#include "wifi_ui.h"
#include "settings.h"
#include "obd2.h"
#include "lever_decoder.h"
#include "coolant.h"
#include "haldex_link.h"
#include "haldex_modes.h"
#include "serial_proto.h"
#include "button_sniffer.h"
#include "ok_clear.h"
#include "config.h"
#include "haldex_espnow.h"
#include <WiFi.h>
#include <esp_wifi.h>
#include <WebServer.h>
#include <ArduinoJson.h>

// =============================================================
//  State
// =============================================================
static WebServer g_server(80);
static bool     g_active   = false;
static String   g_curr_ssid = "";

// Build version is owned by serial_proto; we'll just read SETTINGS_VERSION
// from settings struct for display purposes.

// =============================================================
//  Mobile HTML (served at "/")
//  Kept short + dependency-free so it fits in PROGMEM.
//  Auto-polls /api/status every 500 ms.
// =============================================================
static const char MOBILE_HTML[] PROGMEM = R"HTML(<!DOCTYPE html>
<html lang="fr"><head>
<meta charset="utf-8">
<meta name="viewport" content="width=device-width,initial-scale=1,user-scalable=no">
<title>BOT32 mobile</title>
<style>
  *{box-sizing:border-box;-webkit-tap-highlight-color:transparent}
  body{font-family:-apple-system,Segoe UI,Roboto,sans-serif;background:#1a1a2e;color:#e8e8f0;margin:0;padding:14px;font-size:16px}
  h1{margin:0 0 14px;font-size:22px;color:#7df;display:flex;align-items:center;gap:8px}
  h1 .v{font-size:11px;background:#0a4;padding:2px 7px;border-radius:10px;font-weight:600}
  .grid{display:grid;grid-template-columns:1fr 1fr;gap:10px}
  .card{background:#252540;border-radius:10px;padding:12px;border:1px solid #404060}
  .lbl{font-size:11px;color:#8a8aa0;text-transform:uppercase;letter-spacing:.5px}
  .val{font-size:24px;font-weight:600;margin-top:4px;color:#fff}
  .val.stale{color:#666}
  .can{font-size:10px;color:#666;font-family:monospace;margin-top:2px}
  .actions{margin-top:14px;display:grid;gap:8px}
  button{background:#3a3a5a;color:#fff;border:none;padding:14px;border-radius:10px;font-size:16px;font-weight:600;cursor:pointer;active:bg-#4a4a6a}
  button.danger{background:#a33}
  button.primary{background:#0a4}
  button:active{transform:scale(.98)}
  .status{margin-top:10px;font-size:12px;color:#7af;text-align:center;min-height:18px}
  .conn{position:fixed;top:0;right:0;padding:4px 10px;font-size:10px;background:#0a4;color:#fff;border-radius:0 0 0 8px}
  .clrb{display:none;position:fixed;left:10px;right:10px;top:26px;z-index:9;padding:14px;border-radius:10px;font-size:16px;font-weight:700;text-align:center;color:#fff;box-shadow:0 4px 14px rgba(0,0,0,.5)}
  .conn.off{background:#a33}
  .hx-btns{margin-top:20px;display:flex;gap:8px;justify-content:center;flex-wrap:wrap}
  .hxb{flex:1 1 0;min-width:90px;background:#3a3a5a}
  .hxb.active{outline:2px solid #7df;background:#2a3a6a}
  .card.tap{cursor:pointer}
  .card.armed{border-color:#a33;background:#3a2530}
  .help{margin-top:16px;background:#252540;border:1px solid #404060;border-radius:10px;overflow:hidden}
  .help summary{padding:13px 14px;font-weight:600;color:#7df;cursor:pointer;list-style:none;display:flex;justify-content:space-between}
  .help summary::-webkit-details-marker{display:none}
  .help summary::after{content:'▾';color:#8a8aa0}
  .help[open] summary::after{content:'▴'}
  .combo{padding:11px 14px;border-top:1px solid #404060}
  .combo h3{margin:0 0 7px;font-size:15px;color:#fff;display:flex;align-items:center;gap:8px}
  .k{display:inline-block;background:#3a3a5a;border:1px solid #5a5a80;border-radius:6px;padding:3px 8px;font-size:13px;font-weight:600;white-space:nowrap}
  .plus{color:#8a8aa0;margin:0 4px;font-weight:700}
  .note{font-size:12px;color:#9a9ab0;margin-top:6px;line-height:1.4}
  .warn{padding:10px 14px;border-top:1px solid #404060;font-size:12px;color:#fc8;background:#2e2638;line-height:1.4}
</style></head>
<body>
<div class="conn" id="conn">●</div>
<div class="clrb" id="clrb" onclick="this.style.display='none'"></div>
<h1>BOT32 <span class="v" id="v">—</span></h1>

<div class="grid">
  <div class="card">
    <div class="lbl">Lever</div><div class="val" id="lever">—</div>
    <div class="can">0x394 WBA_03</div>
  </div>
  <div class="card">
    <div class="lbl">MAP mbar</div><div class="val" id="map">—</div>
    <div class="can">DID 0x39C0</div>
  </div>
  <div class="card">
    <div class="lbl">Coolant TX</div><div class="val" id="cool">—</div>
    <div class="can">0x647 Motor_09</div>
  </div>
  <div class="card">
    <div class="lbl">Real coolant</div><div class="val" id="rcool">—</div>
    <div class="can">0x647 RX</div>
  </div>
  <div class="card">
    <div class="lbl">⛽ Ethanol %</div><div class="val" id="eth">—</div>
    <div class="can">DID 0xF452</div>
  </div>
  <div class="card">
    <div class="lbl">🏁 Haldex %</div><div class="val" id="hdx">—</div>
    <div class="can">DID 0x2BF3</div>
  </div>
  <div class="card">
    <div class="lbl">🌡 DSG oil °C</div><div class="val" id="dsg">—</div>
    <div class="can">DID 0x2104</div>
  </div>
  <div class="card">
    <div class="lbl">🔥 EGT °C</div><div class="val" id="egt">—</div>
    <div class="can">DID 0x40D5</div>
  </div>
  <div class="card">
    <div class="lbl">🅿 Hand brake</div><div class="val" id="hbr">—</div>
    <div class="can">0x30B b[2] bit 7</div>
  </div>
  <div class="card">
    <div class="lbl">🅾 OK button</div><div class="val" id="okb">—</div>
    <div class="can">0x5BF b[0]</div>
  </div>
  <div class="card">
    <div class="lbl">⚠ Hazard</div><div class="val" id="hz">—</div>
    <div class="can">0x366 b[2] bit 4</div>
  </div>
  <div class="card">
    <div class="lbl">🚫 TC button</div><div class="val" id="tc">—</div>
    <div class="can">0x0FD b[6]</div>
  </div>
</div>

<h2 style="font-size:14px;color:#7df;margin:16px 0 8px">🏁 Haldex (MITM) <span id="hx-arm" style="font-size:11px;font-weight:700;padding:2px 8px;border-radius:10px;background:#444;color:#fff;vertical-align:middle">—</span></h2>
<div class="grid" id="hx-grid">
  <div class="card"><div class="lbl">Mode</div><div class="val" id="hx-mode">—</div><div class="can">MITM · ESP-NOW</div></div>
  <div class="card"><div class="lbl">Connexion</div><div class="val" id="hx-conn">—</div><div class="can">ESP-NOW</div></div>
  <div class="card"><div class="lbl">Vitesse km/h</div><div class="val" id="hx-spd">—</div><div class="can">0x0FD ESP_21</div></div>
  <div class="card"><div class="lbl">Pédale %</div><div class="val" id="hx-ped">—</div><div class="can">0x121 MOTOR_20 D3</div></div>
  <div class="card"><div class="lbl">Lock target %</div><div class="val" id="hx-tgt">—</div><div class="can">consigne (mode)</div></div>
  <div class="card"><div class="lbl">Pump eng. %</div><div class="val" id="hx-pump">—</div><div class="can">0x118 D3</div></div>
  <div class="card"><div class="lbl">Temp embrayage</div><div class="val" id="hx-temp">—</div><div class="can">0x2BF1 Haldex</div></div>
</div>
<div class="hx-btns">
  <button class="hxb hxb-off" onclick="hmode(0)">🅾 STOCK</button>
  <button class="hxb hxb-fwd" onclick="hmode(1)">🔥 FWD</button>
  <button class="hxb hxb-5050" onclick="hmode(2)">🚀 50/50</button>
</div>

<div class="actions">
  <button onclick="location.href='/settings'">⚙ Tous les réglages</button>
</div>

<details class="help">
  <summary>📖 Aide-mémoire — combinaisons</summary>
  <div class="warn">⚠ Haldex : les modes FWD / 50-50 n'agissent que si le X2 est <b>🔴 ARMÉ</b>. Auto coupée <b>5 min ou plus</b> : retour en <b>STOCK</b> (coupure plus courte : le mode est gardé).</div>
  <div class="combo">
    <h3>🔥 FWD (traction avant)</h3>
    <span class="k">⚠ Hazard ON</span><span class="plus">+</span><span class="k">🚫 TC OFF</span>
    <div class="note">Dans n'importe quel ordre, <b>frein à main baissé</b> (sinon c'est 50/50). Ensuite tu peux éteindre les Hazard : FWD reste actif. Aussi : bouton 🔥 FWD ci-dessus.</div>
  </div>
  <div class="combo">
    <h3>🅾 Retour STOCK</h3>
    <span class="k">🚫 TC ON</span>
    <div class="note">Rallumer le Traction Control (si FWD ou 50/50 a été activé par la combinaison). Après un redémarrage, le TC revient seul à ON sans changer le mode : <b>TC OFF puis ON</b>. Si le mode vient de l'app : bouton 🅾 STOCK.</div>
  </div>
  <div class="combo">
    <h3>🚀 50/50</h3>
    <span class="k">🅿 Frein à main tiré</span><span class="plus">+</span><span class="k">⚠ Hazard ON</span><span class="plus">+</span><span class="k">🚫 TC OFF</span>
    <div class="note">Le frein à main doit être tiré <b>avant</b> de compléter la combinaison (sinon c'est FWD). Ensuite tu peux le relâcher et éteindre les Hazard : 50/50 reste actif. Aussi : bouton 🚀 50/50 ci-dessus.</div>
  </div>
  <div class="combo">
    <h3>🔧 Effacer les codes moteur</h3>
    <span class="k">🅾 OK maintenu</span><span class="plus">pendant</span><span class="k">6 s</span>
    <div class="note">Bouton OK du volant, maintenu enfoncé. Effacement OBD générique (moteur, et codes antipollution de la boîte DSG) : BOT32 passe en écoute seule, le Haldex est remis en STOCK. Message ici si la page est ouverte. Évite l'écran des données de trajet (un appui long les remet à zéro). Aussi : bouton dans ⚙ Tous les réglages.</div>
  </div>
  <div class="combo">
    <h3>📈 Boost sur la jauge de température</h3>
    <span class="k">Levier S</span><span class="plus">ou</span><span class="k">Levier M</span>
    <div class="note">En P / R / N / D, la jauge affiche la vraie température moteur.</div>
  </div>
  <div class="combo">
    <h3>🔓 Armer / désarmer le X2</h3>
    <span class="k">📱 App seulement</span>
    <div class="note">⚙ Tous les réglages → Armement MITM. Le statut 🟢 / 🔴 s'affiche à côté de « Haldex (MITM) ».</div>
  </div>
</details>

<div class="status" id="st">—</div>

<script>
const $ = id => document.getElementById(id);
let lastOk = 0;

async function poll(){
  try{
    const r = await fetch('/api/status',{cache:'no-store'});
    if(!r.ok) throw 0;
    const s = await r.json();
    lastOk = Date.now();
    clrBanner(s);
    $('v').textContent = s.version ? 'v'+s.version : '—';
    $('lever').textContent = (s.lever && s.lever!=='?') ? (s.gear?s.lever+s.gear:s.lever) : '—';
    setVal('map', s.map_mbar>=0 ? Math.round(s.map_mbar) : null);
    setVal('cool', s.coolant_byte!==undefined ? (s.coolant_byte*0.7339-43.94).toFixed(1)+'°' : null, !s.motor09_tx_active);
    setVal('rcool', s.real_coolant_c>=0 ? s.real_coolant_c.toFixed(1)+'°' : null);
    setVal('eth', s.ethanol_pct>=0 ? s.ethanol_pct.toFixed(1)+'%' : null);
    setVal('hdx', s.haldex_blockage_pct>=0 ? s.haldex_blockage_pct.toFixed(1)+'%' : null);
    // v2.8.0 — 3 temps + 2 sniffers (sentinel -1000 = no data for temps)
    setVal('dsg',  (s.dsg_oil_c    !== undefined && s.dsg_oil_c    > -999) ? s.dsg_oil_c.toFixed(0)    + '°' : null);
    setVal('egt',  (s.egt_c        !== undefined && s.egt_c        > -999) ? s.egt_c.toFixed(0)        + '°' : null);
    const hbFresh = (s.handbrake_age_ms !== undefined && s.handbrake_age_ms < 5000);
    setVal('hbr', hbFresh ? (s.handbrake_active ? '✓ ON' : 'OFF') : null);
    const okFresh = (s.ok_button_age_ms !== undefined && s.ok_button_age_ms < 5000);
    setVal('okb', okFresh ? (s.ok_button_pressed ? '✓ PRESS' : 'rel.') : null);
    // v2.9.0 — Hazard + TC sniffers
    const hzFresh = (s.hazard_age_ms !== undefined && s.hazard_age_ms < 5000);
    setVal('hz', hzFresh ? (s.hazard_active ? '✓ ON' : 'OFF') : null);
    const tcFresh = (s.tc_button_age_ms !== undefined && s.tc_button_age_ms < 5000);
    // v2.10.0: bouton tenu = traction control OFF ; relâché = ON (normal)
    setVal('tc', tcFresh ? (s.tc_button_pressed ? 'OFF' : 'ON') : null);
    // v3.1.0 — Haldex (MITM)
    const hx = s.haldex || {};
    const names = ['STOCK','FWD','50/50'];
    const online = !!hx.online;
    // v3.3.0: prefer the mode REPORTED by the X2 (persisted) when online
    const lm = (online && hx.current_mode !== undefined) ? hx.current_mode
             : ((hx.local_mode !== undefined) ? hx.local_mode : 0);
    setVal('hx-mode', names[lm] || '—');
    setVal('hx-conn', online ? '✓ OK' : '✗ off', !online);
    setVal('hx-spd',  online ? hx.vehicle_kmh : null);
    setVal('hx-ped',  online ? (hx.pedal_pct + '%') : null);
    setVal('hx-tgt',  online ? (hx.lock_target_pct + '%') : null);
    setVal('hx-pump', online ? (hx.pump_engagement_pct + '%') : null);
    // armed status -> header badge. passthrough ON = transparent/safe (Pas armé, green);
    // OFF = MITM armed (Armé, red). Arm/disarm itself lives in the settings page.
    const pt = online ? (hx.passthrough ? 1 : 0) : null;
    if(pt!==null) g_pt = pt;   // remember for the arm/disarm button in settings
    const arm = $('hx-arm');
    if(arm){
      if(pt===null){ arm.textContent='— hors-ligne'; arm.style.background='#444'; }
      else if(pt){ arm.textContent='🟢 Pas armé'; arm.style.background='#2a7d46'; }
      else { arm.textContent='🔴 ARMÉ'; arm.style.background='#a33'; }
    }
    // clutch oil temp (Main UDS poll 0x2BF1, data[5]*2.7-241.5) — sentinel -1000 = no data
    setVal('hx-temp', (s.haldex_clutch_temp_c!==undefined && s.haldex_clutch_temp_c>-999)
                      ? s.haldex_clutch_temp_c.toFixed(0)+'°' : null);
    // highlight the active mode button
    document.querySelectorAll('.hxb').forEach((b,i)=>b.classList.toggle('active', i===lm));
    $('conn').classList.remove('off');
    $('conn').textContent='●';
  }catch(e){
    $('conn').classList.add('off');
    $('conn').textContent='✗';
  }
}
// v4.7.0 — clear-engine-codes banner (OK held 6 s on the wheel, phone or PC).
// Baseline at page load: a result older than the page is never shown.
// After a BOT32 reboot (uptime goes down) the counter restarts at 0: re-baseline,
// and never show an 'idle' state as a result.
let clrSeq = null, clrRun = false, clrTimer = null, clrUp = 0;
function clrBanner(s){
  if(s.clear_engine_seq === undefined) return;
  const b = $('clrb');
  const src = s.clear_engine_src ? ' (' + s.clear_engine_src + ')' : '';
  if(s.uptime_ms !== undefined){ if(s.uptime_ms < clrUp && clrSeq !== null) clrSeq = 0; clrUp = s.uptime_ms; }
  if(clrSeq === null){ clrSeq = s.clear_engine_seq; }
  if(s.clear_engine_state === 'running'){
    if(!clrRun){ clrRun = true; clearTimeout(clrTimer);
      b.textContent = '⏳ Effacement des codes moteur…' + src; b.style.background = '#246'; b.style.display = 'block'; }
    return;
  }
  const done = (s.clear_engine_state === 'ok' || s.clear_engine_state === 'fail');
  if(!done){
    clrSeq = s.clear_engine_seq;
    if(clrRun){ clrRun = false; b.style.display = 'none'; }
    return;
  }
  if(s.clear_engine_seq !== clrSeq){
    clrSeq = s.clear_engine_seq; clrRun = false;
    const ok = s.clear_engine_state === 'ok';
    b.textContent = (ok ? '✓ ' : '✗ ') + s.clear_engine_msg + src;
    b.style.background = ok ? '#0a4' : '#a33';
    b.style.display = 'block';
    clearTimeout(clrTimer); clrTimer = setTimeout(() => { b.style.display = 'none'; }, 10000);
  } else if(clrRun){ clrRun = false; b.style.display = 'none'; }
}
function setVal(id, v, stale){
  const el = $(id);
  if(v===null || v===undefined){ el.textContent='—'; el.classList.add('stale'); }
  else{ el.textContent=v; el.classList.toggle('stale', !!stale); }
}
async function cmd(c){
  $('st').textContent='⏳ envoi…';
  try{
    const r = await fetch('/api/cmd',{method:'POST',headers:{'Content-Type':'application/json'},body:JSON.stringify({cmd:c})});
    const j = await r.json();
    $('st').textContent = j.ok ? '✓ '+c+' OK' : '✗ '+c+' '+(j.msg||'fail');
    setTimeout(()=>$('st').textContent='—', 3000);
  }catch(e){ $('st').textContent='✗ erreur réseau'; }
}
async function hmode(m){
  // Confirm before engaging a race mode (FWD / 50-50). STOCK is instant.
  if(m===1 && !confirm('🔥 FWD (traction avant)\n\nMode circuit fermé. Engager FWD ?')) return;
  if(m===2 && !confirm('🚀 50/50 (lock max)\n\nMode circuit fermé. Engager 50/50 ?')) return;
  $('st').textContent='⏳ mode…';
  try{
    const r = await fetch('/api/cmd',{method:'POST',headers:{'Content-Type':'application/json'},body:JSON.stringify({cmd:'set_haldex_mode',mode:m})});
    const j = await r.json();
    $('st').textContent = j.ok ? '✓ Haldex '+(['STOCK','FWD','50/50'][m]) : '✗ '+(j.msg||'fail');
    setTimeout(()=>$('st').textContent='—', 3000);
  }catch(e){ $('st').textContent='✗ erreur réseau'; }
}
let g_pt = 1;  // last known passthrough (updated from /api/status)
async function hpass(){
  const want = g_pt ? false : true;  // toggle
  if(!want && !confirm('⚠ DÉSARMER le passthrough\n\nLe module X2 va MODIFIER les trames Haldex en mode FWD/50-50 (action mécanique réelle).\nCircuit fermé seulement. Continuer ?')) return;
  $('st').textContent='⏳ passthrough…';
  try{
    const r = await fetch('/api/cmd',{method:'POST',headers:{'Content-Type':'application/json'},body:JSON.stringify({cmd:'set_haldex_passthrough',on:want})});
    const j = await r.json();
    $('st').textContent = j.ok ? ('✓ '+(want?'Passthrough ON':'MITM ARMÉ')) : '✗ '+(j.msg||'fail');
    setTimeout(()=>$('st').textContent='—', 3000);
  }catch(e){ $('st').textContent='✗ erreur réseau'; }
}
setInterval(poll, 500);
poll();
</script>
</body></html>)HTML";

// =============================================================
//  Mobile SETTINGS page (served at "/settings")
//  Compact form with all main settings, mirrors PC UI in dark theme.
//  Fetches current values from /api/get_settings, POSTs changes to /api/set.
// =============================================================
static const char SETTINGS_HTML[] PROGMEM = R"HTML(<!DOCTYPE html>
<html lang="fr"><head>
<meta charset="utf-8">
<meta name="viewport" content="width=device-width,initial-scale=1,user-scalable=no">
<title>BOT32 settings</title>
<style>
  *{box-sizing:border-box;-webkit-tap-highlight-color:transparent}
  body{font-family:-apple-system,Segoe UI,Roboto,sans-serif;background:#1a1a2e;color:#e8e8f0;margin:0;padding:14px;font-size:15px;padding-bottom:60px}
  h1{margin:0 0 8px;font-size:20px;color:#7df}
  h2{font-size:14px;color:#7df;border-bottom:1px solid #404060;padding-bottom:4px;margin:18px 0 8px;text-transform:uppercase;letter-spacing:.5px}
  .row{display:grid;grid-template-columns:1fr 1fr;gap:8px;margin-bottom:8px}
  .row.full{grid-template-columns:1fr}
  label{display:block;font-size:11px;color:#8a8aa0;text-transform:uppercase;letter-spacing:.5px;margin-bottom:3px}
  input,select{width:100%;padding:8px;background:#252540;border:1px solid #404060;color:#fff;border-radius:6px;font-size:15px;font-family:inherit}
  input[type=checkbox]{width:22px;height:22px;vertical-align:middle;margin-right:6px}
  .cb{display:flex;align-items:center;font-size:14px;padding:6px 0;color:#e8e8f0}
  .hint{font-size:10px;color:#666;margin-top:2px}
  .save{position:fixed;bottom:0;left:0;right:0;padding:10px 14px;background:#0a4;color:#fff;text-align:center;font-weight:600;font-size:14px}
  .save.err{background:#a33}
  .back{display:inline-block;color:#7df;text-decoration:none;font-size:13px;margin-bottom:10px}
  #clr-btn:disabled{opacity:.5}
</style></head>
<body>
<a class="back" href="/">← Retour live</a>
<h1>⚙ Réglages BOT32</h1>

<h2>🎯 MAP → Gauge mapping</h2>
<div class="row">
  <div><label>MAP min mbar</label><input type="number" data-k="map_min_mbar" min="0" max="4000" step="10"></div>
  <div><label>MAP max mbar</label><input type="number" data-k="map_max_mbar" min="0" max="4000" step="10"></div>
</div>

<h2>🔍 OBD2</h2>
<div class="row">
  <div><label>Poll Hz</label><input type="number" data-k="obd2_poll_hz" min="1" max="30"></div>
</div>

<h2>📡 Diffusion TX</h2>
<div class="row">
  <div><label>TX rate Hz</label><input type="number" data-k="tx_rate_hz" min="5" max="50"></div>
</div>
<label class="cb"><input type="checkbox" data-k="tx_enabled"> 🟢 TX enabled (master)</label>
<label class="cb"><input type="checkbox" data-k="force_tx_always"> 🔧 Force TX in ALL modes</label>

<h2>🔧 Effacer les codes moteur</h2>
<button type="button" id="clr-btn" onclick="clearEngine()" style="width:100%;margin:6px 0 4px;padding:13px;background:#0a4;color:#fff;border:none;border-radius:8px;font-size:15px;font-weight:600">🔧 Effacer les codes moteur</button>
<div class="hint">Effacement OBD générique : moteur, et codes antipollution de la boîte DSG. BOT32 passe en écoute seule (aucune émission sur les bus CAN), le Haldex est remis en STOCK, puis la commande d'effacement OBD est envoyée. Le Haldex reste en STOCK après. Refus ? Essayer moteur arrêté, contact mis.</div>
<div id="clr-st" style="margin:6px 0 12px;font-size:14px;font-weight:600;min-height:18px"></div>
<h2>📶 WiFi AP</h2>
<label class="cb"><input type="checkbox" data-k="wifi_enabled"> 📶 WiFi AP enabled</label>
<div class="row">
  <div><label>SSID</label><input type="text" data-k="wifi_ap_ssid" maxlength="32"></div>
  <div><label>Password (8+)</label><input type="text" data-k="wifi_ap_password" maxlength="63"></div>
</div>

<h2>🏁 Haldex AWD link (ESP-NOW)</h2>
<label class="cb"><input type="checkbox" data-k="haldex_enabled"> 🏁 Haldex link enabled</label>
<div class="row full">
  <div><label>ESP-NOW peer MAC (MITM X2)</label><input type="text" data-k="haldex_espnow_peer_mac" placeholder="FF:FF:FF:FF:FF:FF (broadcast)">
    <div class="hint">Vide = broadcast. Mets le MAC du module X2 pour verrouiller l'appairage.</div></div>
</div>
<div class="row full">
  <div><label>Armement MITM (passthrough)</label>
    <button type="button" onclick="hpass()" style="width:100%;padding:12px;border-radius:8px;border:1px solid #a33;background:#3a2530;color:#fff;font-weight:700">🔓 Armer / 🔒 Désarmer le X2</button>
    <div class="hint">Bascule l'armement. <b>Désarmer</b> = le X2 MODIFIE les trames Haldex (FWD/50-50 deviennent actifs, action mécanique réelle) — circuit fermé seulement. Le statut 🟢 Pas armé / 🔴 ARMÉ s'affiche en haut de la page Live (à côté de « Haldex (MITM) »).</div></div>
</div>

<div class="save" id="save">Touche un champ pour modifier</div>

<script>
async function getStatus(){const r=await fetch('/api/status',{cache:'no-store'});if(!r.ok)throw 0;return r.json()}
async function postCmd(o){const r=await fetch('/api/cmd',{method:'POST',headers:{'Content-Type':'application/json'},body:JSON.stringify(o)});return r.json()}

// v4.6.0 — clear ENGINE codes (listen-only procedure), result polled from /api/status
async function clearEngine(){
  if(!confirm('🔧 Effacer les codes défaut du MOTEUR ?\n\nBOT32 passe en écoute seule, le Haldex est remis en STOCK, puis la commande OBD générique est envoyée (moteur + codes antipollution de la boîte DSG).')) return;
  const st=document.getElementById('clr-st'), btn=document.getElementById('clr-btn');
  const show=(t,c)=>{st.textContent=t;st.style.color=c||'#7af'};
  let seq0;
  try{ seq0=(await getStatus()).clear_engine_seq; }catch(e){ show('✗ erreur réseau','#f66'); return; }
  try{
    const j=await postCmd({cmd:'clear_engine_fault'});
    if(!j.ok){ show('✗ '+(j.msg||'refusé'),'#f66'); return; }
  }catch(e){ show('✗ erreur réseau','#f66'); return; }
  btn.disabled=true; show('⏳ Écoute seule — effacement en cours…');
  const t0=Date.now();
  while(Date.now()-t0<25000){
    await new Promise(r=>setTimeout(r,400));
    try{
      const s=await getStatus();
      if(s.clear_engine_seq!==seq0 && s.clear_engine_state!=='running'){
        btn.disabled=false;
        if(s.clear_engine_state==='ok') show('✓ '+s.clear_engine_msg,'#4c4');
        else show('✗ '+s.clear_engine_msg,'#f66');
        return;
      }
    }catch(e){}
  }
  btn.disabled=false; show('✗ Pas de résultat reçu (vérifie la connexion)','#f66');
}

// v4.6.0 — arm/disarm button on this page (hpass was missing here since v4.2.0)
async function hpass(){
  let hx;
  try{ hx=(await getStatus()).haldex||{}; }catch(e){ setStatus('✗ Erreur réseau', true); return; }
  if(!hx.online){ setStatus('✗ Module Haldex hors-ligne', true); return; }
  const want = hx.passthrough ? false : true;   // toggle
  if(!want && !confirm('⚠ DÉSARMER le passthrough\n\nLe module X2 va MODIFIER les trames Haldex en mode FWD/50-50 (action mécanique réelle).\nCircuit fermé seulement. Continuer ?')) return;
  try{
    const j=await postCmd({cmd:'set_haldex_passthrough',on:want});
    setStatus(j.ok ? (want ? '✓ Passthrough ON (pas armé)' : '✓ MITM ARMÉ') : '✗ '+(j.msg||'échec'), !j.ok);
  }catch(e){ setStatus('✗ Erreur réseau', true); }
}

function toHex(n){return '0x'+Number(n||0).toString(16).toUpperCase().padStart(3,'0')}
function parseHex(s){if(!s)return 0;s=String(s).trim();if(s.startsWith('0x'))return parseInt(s.substring(2),16);if(/[a-fA-F]/.test(s))return parseInt(s,16);return parseInt(s,10)}

async function load(){
  try{
    const r = await fetch('/api/get_settings');
    const s = await r.json();
    document.querySelectorAll('[data-k]').forEach(el=>{
      const k = el.dataset.k;
      if(s[k] === undefined) return;
      if(el.type === 'checkbox'){ el.checked = !!s[k]; }
      else if(el.dataset.hex === '1'){ el.value = toHex(s[k]); }
      else if(el.tagName === 'SELECT'){ el.value = String(s[k]); }
      else { el.value = s[k]; }
    });
    setStatus('Réglages chargés', false);
  }catch(e){ setStatus('Erreur chargement', true); }
}

async function save(k, v){
  setStatus('⏳ Envoi '+k+'...', false);
  try{
    const r = await fetch('/api/set', {method:'POST', headers:{'Content-Type':'application/json'}, body:JSON.stringify({key:k, value:v})});
    const j = await r.json();
    setStatus(j.ok ? '✓ '+k+' sauvegardé' : '✗ '+k+' refusé : '+(j.msg||'?'), !j.ok);
  }catch(e){ setStatus('✗ Erreur réseau', true); }
}

function setStatus(t, err){
  const el = document.getElementById('save');
  el.textContent = t;
  el.classList.toggle('err', !!err);
}

// Auto-save on change/blur
document.querySelectorAll('[data-k]').forEach(el=>{
  const ev = (el.type==='checkbox'||el.tagName==='SELECT') ? 'change' : 'blur';
  el.addEventListener(ev, ()=>{
    const k = el.dataset.k;
    let v;
    if(el.type === 'checkbox'){ v = el.checked; }
    else if(el.dataset.hex === '1'){
      v = parseHex(el.value);
      el.value = toHex(v);
    }
    else if(el.type === 'number'){ v = +el.value; }
    else { v = el.value; }

    // v2.7.1: bench mode UX — warn about jumper + auto TX toggle
    if(k === 'bench_test_enabled'){
      if(v){
        if(!confirm('Activer bench mode?\n\n1. Mets jumpers 120Ω HAT en ON\n2. TX sera auto-activé\n3. TX sera restauré au disable\n\nOK ?')){
          el.checked = false;
          return;
        }
      } else {
        if(!confirm('Désactiver bench mode?\n\n1. Remets jumpers 120Ω en OFF\n2. TX sera remis à son état précédent\n\nOK ?')){
          el.checked = true;
          return;
        }
      }
    }

    save(k, v);
  });
});

load();
</script>
</body></html>)HTML";

// =============================================================
//  Route handlers
// =============================================================
static void handle_root() {
  g_server.send_P(200, "text/html", MOBILE_HTML);
}

static void handle_status() {
  // Build the same status payload as serial_proto::emit_status, just trimmed
  // to the fields the mobile UI actually displays.
  JsonDocument doc;
  doc["version"]     = "4.8.1";   // keep in sync with BUILD_VERSION
  doc["uptime_ms"]   = millis();
  doc["lever"]       = String(lever_get());
  doc["gear"]        = lever_get_gear();
  doc["map_mbar"]    = obd2_get_last_map_mbar();
  doc["coolant_byte"] = (uint8_t)0;   // placeholder; mobile UI computes temp itself
  // For coolant: re-derive from current MAP so phone shows what BOT32 would TX
  float map = obd2_get_last_map_mbar();
  const Settings& s = settings_get();
  if (map < 0) map = s.map_min_mbar;
  doc["coolant_byte"] = coolant_map_mbar_to_byte(map, s.map_min_mbar, s.map_max_mbar);
  doc["motor09_tx_active"] = s.tx_enabled;  // simplified — mobile doesn't need full mode logic
  doc["real_coolant_c"]    = coolant_get_real_temp_c();
  doc["ethanol_pct"]       = obd2_get_last_ethanol_pct();
  doc["haldex_blockage_pct"] = obd2_get_last_haldex_blockage_pct();
  // v2.10.0 — 2 temps (DSG + EGT) + sniffer flags for mobile live grid
  doc["dsg_oil_c"]       = obd2_get_last_dsg_oil_c();
  doc["egt_c"]           = obd2_get_last_egt_c();
  doc["haldex_clutch_temp_c"] = obd2_get_last_haldex_clutch_temp_c();   // v4.2.0 (0x2BF1)
  // v2.10.0: engine oil temp removed from mobile status.
  doc["handbrake_active"]  = button_sniffer_handbrake_active();
  doc["handbrake_age_ms"]  = button_sniffer_handbrake_age_ms();
  doc["ok_button_pressed"] = button_sniffer_ok_pressed();
  doc["ok_button_age_ms"]  = button_sniffer_ok_age_ms();
  {                                         // v4.8.0 — OK hold diagnostics (JSON only)
    OkDiag d; button_sniffer_ok_diag(d);
    JsonObject o = doc["ok_diag"].to<JsonObject>();
    o["frames"]        = d.frames;
    o["gap_ms"]        = d.gap_ms;
    o["press_ms"]      = d.press_len_ms;
    o["press_frames"]  = d.press_frames;
    o["press_gap_ms"]  = d.press_gap_ms;
    o["press_codes"]   = d.press_codes;
    o["press_blips"]   = d.press_blips;
    o["press_events"]  = button_sniffer_ok_press_events();
    o["hold_ms"]       = ok_clear_hold_ms();
    o["last_hold_ms"]  = ok_clear_last_hold_ms();
    o["last_hold_end"] = ok_clear_last_end();
  }
  // v2.9.0 — Hazard + TC button sniffers
  doc["hazard_active"]     = button_sniffer_hazard_active();
  doc["hazard_age_ms"]     = button_sniffer_hazard_age_ms();
  doc["tc_button_pressed"] = button_sniffer_tc_pressed();
  doc["tc_button_age_ms"]  = button_sniffer_tc_age_ms();
  // v4.6.0 — clear-engine-codes procedure (result shown by the settings page)
  doc["clear_engine_state"] = obd2_clear_engine_state();
  doc["clear_engine_msg"]   = obd2_clear_engine_msg();
  doc["clear_engine_seq"]   = obd2_clear_engine_seq();
  doc["clear_engine_src"]   = obd2_clear_engine_source();   // v4.7.0

  // v3.1.0 — Haldex (MITM) live + locally-decided mode for the mobile UI
  {
    HaldexState hx = haldex_link_get_state();
    uint32_t hx_age = haldex_link_get_age_ms();
    JsonObject hxo = doc["haldex"].to<JsonObject>();
    hxo["online"]              = hx.valid && (hx_age < HALDEX_LINK_STALE_MS);
    hxo["age_ms"]              = hx_age;
    hxo["local_mode"]          = haldex_modes_get();
    hxo["current_mode"]        = hx.current_mode;   // v3.3.0: actual mode from the X2
    hxo["vehicle_kmh"]         = hx.vehicle_kmh;
    hxo["pedal_pct"]           = hx.pedal_pct;
    hxo["lock_target_pct"]     = hx.lock_target_pct;
    hxo["pump_engagement_pct"] = hx.pump_engagement_pct;
    hxo["passthrough"]         = hx.passthrough;                       // actual (from X2)
    hxo["passthrough_desired"] = haldex_modes_get_passthrough_desired();
  }

  String out;
  serializeJson(doc, out);
  g_server.send(200, "application/json", out);
}

static void handle_settings_page() {
  // Serve the mobile settings HTML
  g_server.send_P(200, "text/html", SETTINGS_HTML);
}

static void handle_api_get_settings() {
  // Full settings dump (includes password — user is on private WiFi anyway)
  const Settings& s = settings_get();
  JsonDocument doc;
  doc["map_min_mbar"]              = s.map_min_mbar;
  doc["map_max_mbar"]              = s.map_max_mbar;
  doc["obd2_req_id"]               = s.obd2_req_id;
  doc["obd2_resp_id"]              = s.obd2_resp_id;
  doc["obd2_did_map"]              = s.obd2_did_map;
  doc["obd2_poll_hz"]              = s.obd2_poll_hz;
  doc["tx_rate_hz"]                = s.tx_rate_hz;
  doc["cluster_motor09_id"]        = s.cluster_motor09_id;
  doc["cluster_wba03_id"]          = s.cluster_wba03_id;
  doc["tx_enabled"]                = s.tx_enabled;
  doc["force_tx_always"]           = s.force_tx_always;
  doc["poll_ethanol"]              = s.poll_ethanol;
  doc["poll_haldex_blockage"]      = s.poll_haldex_blockage;
  doc["bench_test_enabled"]        = s.bench_test_enabled;
  doc["bench_test_bus"]            = s.bench_test_bus;
  doc["bench_rpm"]                 = s.bench_rpm;
  doc["bench_map_mbar"]            = s.bench_map_mbar;
  doc["bench_speed_kmh"]           = s.bench_speed_kmh;
  // v2.9.0: bench_display_value_pct + bench_force_override removed.
  // v2.9.0: 7 cluster_override / display_* settings removed.
  doc["cef_auto_enabled"]              = s.cef_auto_enabled;
  doc["cef_trigger_can_id"]            = s.cef_trigger_can_id;
  doc["cef_trigger_byte_idx"]          = s.cef_trigger_byte_idx;
  doc["cef_trigger_rest_value"]        = s.cef_trigger_rest_value;
  doc["cef_trigger_pressed_value"]     = s.cef_trigger_pressed_value;
  doc["cef_press_count"]               = s.cef_press_count;
  doc["cef_press_window_ms"]           = s.cef_press_window_ms;
  doc["wifi_enabled"]              = s.wifi_enabled;
  doc["wifi_ap_ssid"]              = s.wifi_ap_ssid;
  doc["wifi_ap_password"]          = s.wifi_ap_password;
  doc["haldex_enabled"]            = s.haldex_enabled;
  // v3.2.0: haldex_bus/state_id/cmd_id/transport removed (ESP-NOW only).
  doc["haldex_espnow_peer_mac"]    = s.haldex_espnow_peer_mac;
  String out;
  serializeJson(doc, out);
  g_server.send(200, "application/json", out);
}

static void handle_api_set() {
  if (!g_server.hasArg("plain")) {
    g_server.send(400, "application/json", "{\"ok\":false,\"msg\":\"no body\"}");
    return;
  }
  JsonDocument doc;
  DeserializationError err = deserializeJson(doc, g_server.arg("plain"));
  if (err) {
    g_server.send(400, "application/json", "{\"ok\":false,\"msg\":\"bad JSON\"}");
    return;
  }
  const char* key = doc["key"];
  if (!key) {
    g_server.send(400, "application/json", "{\"ok\":false,\"msg\":\"no key\"}");
    return;
  }
  // Delegate to the shared dispatch in serial_proto.cpp
  bool ok = serial_proto_apply_setting(key, doc["value"]);
  String out = "{\"ok\":";
  out += ok ? "true" : "false";
  out += ok ? ",\"msg\":\"saved\"}" : ",\"msg\":\"unknown key or invalid value\"}";
  g_server.send(200, "application/json", out);
}

static void handle_cmd() {
  if (!g_server.hasArg("plain")) {
    g_server.send(400, "application/json", "{\"ok\":false,\"msg\":\"no body\"}");
    return;
  }
  JsonDocument doc;
  DeserializationError err = deserializeJson(doc, g_server.arg("plain"));
  if (err) {
    g_server.send(400, "application/json", "{\"ok\":false,\"msg\":\"bad JSON\"}");
    return;
  }
  const char* cmd = doc["cmd"];
  if (!cmd) {
    g_server.send(400, "application/json", "{\"ok\":false,\"msg\":\"no cmd\"}");
    return;
  }
  bool ok = false;
  const char* msg = "ok";
  if (strcmp(cmd, "clear_engine_fault") == 0) {
    ok = obd2_clear_engine_start("cellulaire");   // v4.6.0: async, engine only
    msg = ok ? "started" : "busy (already running)";
  } else if (strcmp(cmd, "set_haldex_mode") == 0) {
    uint8_t mode = doc["mode"] | 0;
    ok = haldex_modes_set_manual(mode);   // v3.1.0: via mode logic
    msg = ok ? "mode set" : "Haldex disabled or bad mode";
  } else if (strcmp(cmd, "set_haldex_passthrough") == 0) {
    bool pt = doc["on"] | true;           // v3.2.0: default safe (ON)
    ok = haldex_modes_set_passthrough(pt);
    msg = ok ? (pt ? "passthrough ON" : "MITM armed") : "Haldex disabled";
  } else {
    msg = "unknown cmd";
  }
  String out = "{\"ok\":";
  out += ok ? "true" : "false";
  out += ",\"msg\":\"";
  out += msg;
  out += "\"}";
  g_server.send(200, "application/json", out);
}

static void handle_not_found() {
  g_server.send(404, "text/plain", "Not found");
}

// =============================================================
//  Lifecycle
// =============================================================
void wifi_ui_init() {
  // Module init only — actual AP start is in wifi_ui_apply().
  g_active = false;
}

void wifi_ui_haldex_link_on() {
  // Add STA in place (AP -> AP+STA, esp_wifi_set_mode only): the phone stays
  // connected and ESP-NOW is kept. Restarting the AP from AP-only mode would
  // de-initialise the WiFi driver, and ESP-NOW with it.
  if (WiFi.getMode() == WIFI_AP) {
    WiFi.mode(WIFI_AP_STA);
    WiFi.setSleep(false);
    esp_wifi_set_ps(WIFI_PS_NONE);
  }
  haldex_espnow_init();   // no-op if running; sets ESP-NOW up again after a driver restart
}

// softAPdisconnect(true) from AP-only mode turns WiFi off (driver de-init),
// which wipes ESP-NOW: tell haldex_espnow so it is set up again when needed.
static void stop_ap() {
  bool driver_off = (WiFi.getMode() == WIFI_AP);
  WiFi.softAPdisconnect(true);
  if (driver_off) haldex_espnow_invalidate();
}

void wifi_ui_apply() {
  const Settings& s = settings_get();

  if (!s.wifi_enabled) {
    if (g_active) {
      g_server.stop();
      stop_ap();
      Serial.println("[wifi_ui] AP stopped");
    }
    g_active = false;
    return;
  }

  // v2.6.1 FIX: always restart on apply. Previous check only tracked SSID
  // change, so password edits were silently ignored. Now we always tear
  // down + restart with current SSID/password.
  if (g_active) {
    g_server.stop();
    stop_ap();
    delay(100);
    g_active = false;
  }

  // v3.1.0: the Haldex link is ESP-NOW only. When it's enabled we run AP+STA
  // so the phone AP and the ESP-NOW link coexist, and we LOCK the AP to a
  // fixed channel (ESP-NOW must share the AP's radio channel; the MITM X2
  // locks the same channel).
  bool need_sta = s.haldex_enabled;   // ESP-NOW transport is now the only one
  if (need_sta) {
    WiFi.mode(WIFI_AP_STA);
  } else {
    WiFi.mode(WIFI_AP);
  }

  // softAP(ssid, pass, channel, hidden=0, max_conn=4)
  bool started = WiFi.softAP(s.wifi_ap_ssid, s.wifi_ap_password, WIFI_AP_CHANNEL);
  if (!started) {
    Serial.println("[wifi_ui] softAP FAILED");
    return;
  }
  // v3.9.0: WIFI_AP_STA re-enables modem power-save by default, which would
  // drop the X2's ESP-NOW broadcasts. Re-assert PS OFF after the mode change.
  WiFi.setSleep(false);
  Serial.print("[wifi_ui] AP locked to channel ");
  Serial.print(WIFI_AP_CHANNEL);
  Serial.print(", PS=OFF");
  Serial.println(need_sta ? " (AP+STA for ESP-NOW coexistence)" : " (AP only)");
  g_curr_ssid = String(s.wifi_ap_ssid);

  g_server.on("/",                  HTTP_GET,  handle_root);
  g_server.on("/settings",          HTTP_GET,  handle_settings_page);     // v2.6.1: full mobile settings UI
  g_server.on("/api/status",        HTTP_GET,  handle_status);
  g_server.on("/api/get_settings",  HTTP_GET,  handle_api_get_settings);  // v2.6.1: full settings JSON dump
  g_server.on("/api/set",           HTTP_POST, handle_api_set);           // v2.6.1: update one setting
  g_server.on("/api/cmd",           HTTP_POST, handle_cmd);
  g_server.onNotFound(handle_not_found);
  g_server.begin();

  g_active = true;
  Serial.print("[wifi_ui] AP started: SSID=\"");
  Serial.print(s.wifi_ap_ssid);
  Serial.print("\" IP=http://");
  Serial.println(WiFi.softAPIP());
}

void wifi_ui_tick() {
  if (!g_active) return;
  g_server.handleClient();
}

// =============================================================
//  Diagnostic accessors
// =============================================================
bool   wifi_ui_is_active()    { return g_active; }
String wifi_ui_get_ip()       { return g_active ? WiFi.softAPIP().toString() : String(""); }
String wifi_ui_get_ssid()     { return g_active ? g_curr_ssid : String(""); }
uint8_t wifi_ui_get_n_clients() { return g_active ? WiFi.softAPgetStationNum() : 0; }
