ALagrandeur/BOT32/(commit log)

2026-05-19 Initial commit: project skeleton
    In-vehicle boost-on-coolant override for VW MK7 cluster on ESP32.
    Successor to MK7BoostGauge (Pi version, archived due to MCP2515 issues).
    Logic ported from mk7-cluster-bench-controller.
    Initial structure:
    - README.md: project description, architecture, status
    - LICENSE: MIT
    - BOT32/BOT32.ino: main sketch skeleton with state machine
    (MODE_BOOT, MODE_SILENT, MODE_BOOST, MODE_SAFE_FAULT)
    - BOT32/config.h: all CAN IDs, formulas, rates, pin assignments
    - BOT32/vw_mqb.h+cpp: full port of openpilot MQB CRC8H2F + counter
    constants for IDs we might use (0x040, 0x116, 0x31E, 0x32A, 0x394,
    0x3C0, 0x641). Note: in-vehicle we don't TX these (gateway does)
    but in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
    [BOT32.ino, config.h, coolant.cpp, coolant.h, vw_mqb.cpp, vw_mqb.h]
2026-05-19 Hardware decided: Option A (TWAI cluster + MCP2515 OBD2)
    - docs/wiring.md: detailed wiring schema (~370 lines)
    * Component list with prices ($64 CAD total)
    * ESP32-DevKitC-V4 pinout reference diagram
    * Full system block diagram (ASCII)
    * Exhaustive connection tables (power, CAN0, CAN1)
    * Critical: level shifter required on MISO+INT (5V MCP2515 -> 3.3V ESP32)
    * OBD2 J1962 connector pinout (pins 6/14/16/4)
    * MK7 cluster 18-pin connector pinout (pins 17/18 via T-tap)
    * 3-step assembly procedure: bench test, cluster bench, vehicle install
    * BOM ready to order
    - BOT32/config.h: finalized pin assignments
    * CAN0 TWAI: GPIO 21 TX, GPIO 22 RX -> SN65HVD230 (3.3V) cluster
    * CAN1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
2026-05-19 Core firmware + web UI complete (compile-ready, untested on hardware)
    ESP32 firmware (BOT32/):
    - can_handler.h/cpp: unified API wrapping TWAI (cluster, internal) and
    MCP2515 (OBD2, via ACAN2515 library). Hardcoded forbidden-IDs blocklist
    (0x040, 0x572). Per-channel TX/RX stats. Auto bus-off recovery for TWAI.
    - obd2.h/cpp: periodic UDS ReadDataByIdentifier query for DID 0x39C0
    (Saugrohrdruck/MAP, mbar). Parses 0x7E8 positive response. Stale timeout.
    - lever_decoder.h/cpp: WBA_03 (0x394) byte 1 high nibble -> P/R/N/D/S/M.
    Decodes engaged gear digit (byte 3 low nibble) for S/M/D. is_boost_mode()
    returns true for S/M/N (matches sister project).
    - settings.h/cpp: NVS persistence via Pr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
2026-05-19 Switch from TWAI+MCP2515 to 2x MCP2515 (reuse WaveShare 2-CH CAN HAT)
    User has a WaveShare 2-CH CAN HAT already on hand. Better to reuse it
    than buy separate transceivers + level shifter:
    - Both MCP2515 chips, both with SIT65HVD230 (3.3V transceivers)
    - HAT exposes 9 pins on the Pi GPIO header that we wire directly to
    ESP32 via 10 Dupont jumpers
    - No level shifter needed (all 3.3V)
    - Termination jumpers + screw terminals already on the HAT
    - ~$15 vs ~$64 hardware cost reduction
    Code changes:
    - BOT32/config.h: removed PIN_CAN0_TX/RX (TWAI), added shared SPI pins
    (SCK 18, MISO 19, MOSI 23), CAN0 CS=5 INT=4, CAN1 CS=25 INT=26.
    MCP2515_CLOCK_MHZ changed 8 -> 12 (WaveShare HAT crystals are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
2026-05-19 Full review fixes + pre-flight checklist
    CRITICAL FIX:
    - MCP2515_CLOCK_MHZ: 12 -> 16 (verified WaveShare 2-CH CAN HAT uses 16 MHz
    crystals per official wiki). With wrong value, chip would initialize OK
    but bit rate would be 666 kbps instead of 500 -> zero CAN traffic.
    Added prominent docs explaining diagnostic for this exact bug.
    Other fixes:
    - BOT32/can_handler.h: outdated TWAI/SN65HVD230/TJA1050 mentions cleaned up,
    now correctly describes 2x MCP2515 on shared SPI architecture.
    - BOT32/serial_proto.h+cpp: added serial_proto_set_mode() and
    serial_proto_set_coolant_byte() setters. Status JSON now includes
    "mode" and "coolant_byte" fields.
    - BOT32/BOT32.ino: calls set_mode() on e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
    [BOT32.ino, can_handler.h, config.h, serial_proto.cpp, serial_proto.h]
2026-05-19 UI overhaul: per-section CAN IDs editor + force-TX + airbag toggle + browser autoopen
    Per user feedback (5 modifications):
    1. UI: removed Mode field from live status (kept lever/MAP/coolant byte).
    Renamed 'CAN cluster (TWAI)' -> 'CAN cluster (MCP2515 #0)' since we
    no longer use TWAI.
    2. New setting 'force_tx_always': when ON, BOT32 TXs Motor_09 in ALL modes
    (incl P/R/D and BOOT). Useful for bench diagnostic without moving the
    lever. Also forces OBD2 polling to be active.
    Default OFF (normal behavior: TX only in S/M/N).
    - settings.h/cpp: new field + getter/setter, NVS persisted.
    - serial_proto.cpp: emit + accept in JSON.
    - BOT32.ino: tx_motor_09_if_due() honors it. o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
    [BOT32.ino, can_handler.cpp, lever_decoder.cpp, obd2.cpp, serial_proto.cpp, server.py, settings.cpp, settings.h]
2026-05-19 Add bench test mode: standalone cluster TX bundle + RPM/MAP sliders
    New module bench_test.h/cpp emits the full sister-project frame bundle
    when settings.bench_test_enabled is ON. Lets the user test ESP32 ↔ cluster
    communication on a workbench (no vehicle) by alternately connecting the
    cluster to CAN0 or CAN1.
    Bench frames emitted (matching mk7-cluster-bench-controller):
    0x3C0 Klemmen_Status_01 wake 10 Hz MQB CRC + counter
    0x641 Motor_Code_01 alive 20 Hz MQB CRC + counter
    0x107 Motor_04 RPM 20 Hz no CRC, bytes 3-4 LE = rpm/3
    0x647 Motor_09 coolant 20 Hz no CRC, byte 0 = MAP→byte mapping
    0x106 ESP_05 10 Hz no CRC
    0x11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
2026-05-19 Pre-flash audit: BOOT phase safety guard + OBD2 diagnostic counters
    After full code audit before first flash on ESP32, found and fixed:
    CRITICAL safety fix:
    - BOT32/BOT32.ino: tx_motor_09_if_due() now explicitly refuses to TX
    during MODE_BOOT (5s listen-only) and MODE_SAFE_FAULT, regardless of
    force_tx_always. The boot phase is a safety feature to let the bus
    settle and listen before our first frame — must not be bypassable
    by a diagnostic toggle. force_tx_always now only bypasses the LEVER
    check (allowing TX in P/R/D), not the BOOT/FAULT guards.
    Diagnostic improvements:
    - BOT32/obd2.h+cpp: expose query/response counters via getters
    (obd2_get_queries_sent / responses_ok / res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
    [BOT32.ino, obd2.cpp, obd2.h, serial_proto.cpp]
2026-05-19 Mark v1.0 bench-validated — both CAN0 and CAN1 working with real cluster
    Tested on bench (no vehicle) with WaveShare 2-CH CAN HAT wired to
    ESP32-DevKitC. Bench test mode emits the full sister-project bundle
    (Wake + Engine context + RPM + Coolant + ESP/TSK/EPS heartbeats) on
    the selected bus; cluster receives all frames and reacts to both
    sliders (RPM tachometer needle moves, coolant gauge needle moves).
    Both MCP2515 chips validated:
    - CAN0 bornier test: cluster reacts ✓
    - CAN1 bornier test: cluster reacts ✓ (after moving the cluster wires)
    Confirms:
    - 2x MCP2515 on shared SPI bus correctly addressable via CS/INT pins
    - 16 MHz crystal config matches WaveShare HAT spec
    - MQB CRC8H2F +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
2026-05-23 v1.1.0 savepoint — vehicle OBD2 listen-only validated
    Confirmed in vehicle on 2026-05-23:
    - OBD2 UDS query DID 0x39C0 returns live MAP value (mbar)
    - Lever decode from WBA_03 0x394 works (P/R/N/D/S/M + gear digit)
    - BOT32 listen-only mode: tx_enabled=OFF + force_tx_always=ON works
    - No bus errors observed
    - No interference with vehicle operation
    Known issues (to fix in v1.2):
    1. 'Coolant byte' field in Live Status shows our internally-computed
    override byte, not the real cluster coolant temp. Label is misleading.
    2. Needle position on cluster is non-proportional to MAP when TX is
    active: dead zone skip mapping is biased toward bottom half
    (len_bottom=29 vs len_top=19), so MAP at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
2026-05-23 v1.2.0 — Real coolant sniffer + 50/50 needle mapping
    Two issues fixed from v1.1 vehicle testing:
    ISSUE #1 (Coolant byte misleading):
    - UI label 'Coolant byte' was confusing: showed our internally-computed
    override (default 0x80 = 50C if not TXing), not the real cluster temp.
    - Split into TWO distinct UI fields in Live Status:
    * 'Coolant override (we TX)': shows our computed value as DEGC,
    with the raw byte as a smaller sub-label. Displays only when
    Motor_09 is actually being transmitted (BOOST mode, bench mode,
    or force_tx_always). Otherwise shows '—' with 'TX inactif' note.
    * 'Real coolant (cluster sniff)': NEW field. Sniffs Motor_09 (0x647)
    on CAN0 cluster bus an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
    [BOT32.ino, coolant.cpp, coolant.h, serial_proto.cpp]
2026-05-24 UI reorg: group settings into 4 sections with collapsible cards
    No firmware changes. No app.js changes. Only HTML structure + CSS.
    All input IDs preserved -> existing event handlers continue to work.
    New layout:
    SECTION 1 — 🔌 Connexion (always visible)
    - Serial connection card
    SECTION 2 — 📊 Données live (live status always open, monitor collapsed)
    - Live status (always expanded)
    - Frame monitor (collapsible)
    SECTION 3 — ⚙️ Configuration (4 collapsible cards, all closed by default)
    - 🎯 MAP → Gauge mapping (MAP min/max, scale, offset)
    - 🆔 Communication CAN (CAN0 cluster IDs + CAN1 OBD2 IDs + rates +
    TX gate, all in one card with 4 sub-sections)
    -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
2026-05-24 Add roadmap: Clear-DTC + Haldex AWD MITM (UI placeholders + technical doc)
    NO firmware changes. UI + docs only.
    Adds 2 placeholder cards in the web UI under a new section
    '🔮 Roadmap — Fonctions futures' (between Diagnostics and end of page):
    1. 🔮 Clear DTC via MFSW combo
    - Coming-soon badge + status indicators
    - Disabled-state placeholder controls (combo selector, hold ms,
    manual trigger button) — visually styled with hatched background
    and reduced opacity so user sees the planned UX
    - Reference to docs/future_features.md for technical specs
    2. 🔮 Haldex AWD pump monitor + control
    - Coming-soon badge + 'requires extra hardware' warning
    - Disabled-state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
2026-05-24 Haldex feature refined for motorsport use case (burnout + launch race modes)
    User clarification: vehicle is used in closed-circuit only (drag racing,
    track day). The Haldex control is specifically for race day workflow:
    - BURNOUT mode: force Haldex pump to 0% (FWD only) to spin front tires
    in place and warm them up before staging. Held ~10 seconds.
    - LAUNCH mode: force pump to 100% (50/50 AWD split) at the start line
    for maximum mechanical grip during 0-60 acceleration.
    - OFF mode: default, Haldex controller does its own thing.
    This is much simpler than the original 'continuous slider override'
    spec. Cleaner UX, fewer ways to mess up, and safer because:
    - Auto-revert timers (10s burnou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
2026-05-24 Add 'Push all settings' button in header (force-sync UX)
    Per user request: button in the top header (right side, next to the
    connection pill) to force-push ALL current form values to the ESP32 in
    one batch.
    Behavior:
    - Settings are STILL auto-pushed on blur/change (existing behavior kept)
    - New button iterates SETTING_KEYS and emits a 'set' command per field
    - Visual feedback: button turns green '✓ Sent N settings' for 1.8s
    - Disabled briefly to avoid double-click
    Use case: when user wants to be 100% sure the ESP32 has exactly what's
    on screen (e.g., after a connection drop, after a factory_reset, or
    just for peace of mind before a vehicle test).
    HTML: <button id='btn-push-all'> wrapped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
2026-05-25 v1.3.0 — Haldex AWD link (client side, talks to external MITM module)
    Implements BOT32's side of a Haldex AWD MITM architecture. BOT32 is the
    CLIENT — it sends mode commands and reads state broadcasts over CAN.
    The actual Haldex bus man-in-the-middle runs on SEPARATE hardware (user's
    2nd ESP32 with 2 CAN modules, OR the official OpenHaldex-C6 PCB).
    ALL CODE IN THIS COMMIT IS FRESHLY WRITTEN FOR BOT32 (MIT-licensed).
    No source code, PCB designs, or binaries from OpenHaldex-C6 are included.
    Only publicly documented protocol facts (CAN IDs, mode numbering) are
    referenced — facts are not copyrightable.
    Prominent attribution added in:
    - README.md (new 'Acknowledgments' section thanking Fo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
2026-05-25 v1.4.0 — ESP-NOW transport for Haldex link (wireless to MITM ESP32)
    Adds a 2nd transport option for the Haldex link: ESP-NOW (wireless
    peer-to-peer between BOT32 and the MITM ESP32). Selectable via
    new setting 'haldex_transport' (0 = CAN as before, 1 = ESP-NOW).
    Use case: when the MITM ESP32 sits physically away from BOT32 (e.g.,
    near the rear axle / Haldex unit) and its 2 CAN modules are both
    dedicated to the private Haldex bus MITM (no chassis CAN connection
    available). ESP-NOW lets the two devices exchange state + commands
    without any wires between them.
    ESP-NOW protocol (BOT32-specific, freshly designed for v1.4):
    - All packets start with magic header 0xBA 0xB0 (filters unrelated ESP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
2026-05-25 v1.5.0 — BOT32-Haldex MITM skeleton sub-project (MIT, pass-through default)
    Sister Arduino sketch for a 2nd ESP32 + WaveShare 2-CH CAN HAT that sits
    physically between the PCM and the Haldex AWD controller on the private
    Haldex sub-bus. Talks to BOT32 main wirelessly via ESP-NOW.
    Skeleton ships as a transparent CAN bridge so the hardware install can be
    validated safely BEFORE any mode-specific logic is added. The actual
    Haldex demand-frame modification lives in haldex_mitm.cpp as two clearly
    marked STUB blocks (TODO #1 / TODO #2) that the user fills in from their
    own knowledge or a personal fork of OpenHaldex-C6.
    What's included (all freshly written, MIT):
    - BOT32-Haldex.ino — setup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
2026-05-25 v1.5.1 — Fix ESP-NOW callback signatures for Arduino-ESP32 Core 3.x
    The ESP-NOW callbacks changed signatures between Core 2.x and 3.x:
    - recv: (uint8_t* mac, ...) -> (esp_now_recv_info_t* info, ...)
    - sent: (uint8_t* mac, status) -> (wifi_tx_info_t* tx_info, status)
    Use ESP_IDF_VERSION to pick the right signature at compile time, with
    a shared on_data_recv_impl() so the protocol parsing stays single-source.
    Backward-compatible with Core 2.x.
    Reported on real install (Core 3.3.8) — compile error blocked v1.5.0 flash.
    [haldex_espnow.cpp]
2026-05-25 v1.5.2 — Recalibrate MAP defaults for EA888 + bump TX rate to 30 Hz
    Vehicle test feedback (v1.5.1 in real car):
    - At MAP=1000 mbar (atmospheric, light boost), needle stayed at ~68°C
    (bottom half of gauge) instead of crossing to upper half.
    - Cause: with map_min=300, map_max=2500, ratio at 1000 mbar = 0.32
    so the dead-zone jump (at ratio=0.5) was happening at MAP=1400 mbar,
    too high for visible response on light boost.
    Recalibration so the dead-zone jump aligns with the vacuum->boost transition:
    - map_min: 300 -> 0 (idle vacuum still in bottom 1/4 of needle range)
    - map_max: 2500 -> 2000 (130°C = full EA888 boost, was overshot)
    - With these, ratio = 0.5 at MAP =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
    [config.h, settings.cpp]
2026-05-25 chore: stamp version on .ino line 2 + sync BUILD_VERSION
    Per user request: every .ino file now carries the current release tag
    on line 2 of the header comment, with a direct link to the GitHub
    release. Going forward, this marker MUST be updated as part of every
    version bump (along with BUILD_VERSION in serial_proto.cpp and
    SETTINGS_VERSION in settings.cpp when applicable).
    Also fix BUILD_VERSION which was stuck at "0.1" — the web UI boot
    banner now correctly shows the firmware version.
    [BOT32.ino, serial_proto.cpp]
2026-05-25 v1.6.0 — Linear mapping by default, N silent, drop scale/offset
    User feedback from real-vehicle testing of v1.5.2:
    1. In bench (slider), needle response is linear — no dead zone observed.
    2. In car, needle moves too fast through the middle (the v1.5 "50/50
    dead-zone-aware" mapping was overcorrecting for a damping effect
    that doesn't exist on this cluster).
    3. Lever N should behave like P/R/D (silent), not trigger BOOST.
    4. scale + offset_c fine-tune params are not useful in practice.
    Changes:
    - Mapping: LINEAR by default (smooth proportional).
    Dead-zone-aware mode kept as opt-in toggle (`use_dead_zone_mapping`)
    for users who DO observe needle damping in their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
    [BOT32.ino, bench_test.cpp, config.h, coolant.cpp, coolant.h, lever_decoder.cpp, lever_decoder.h, serial_proto.cpp]
2026-05-25 v2.0.0 — Boost feature officially stable
    Three vehicle-test-confirmed fixes that bring the boost-on-coolant
    feature to a clean v2.0 release:
    1. UI hint corrected: "S/M/N" -> "S/M" (lever N is now silent like
    P/R/D, matching the v1.6.0 firmware behavior).
    2. "Coolant override" live display now always shows the would-be byte
    (computed from current MAP + settings, regardless of TX state).
    - SILENT mode (P/R/N/D) shows "(preview - TX inactif)" with greyed
    value so the user can monitor calibration without entering S/M.
    - BOOST mode / bench mode shows the live actively-transmitted value.
    Serial proto now computes live_coolant_byte on every emit_status()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
    [BOT32.ino, bench_test.cpp, config.h, coolant.cpp, coolant.h, serial_proto.cpp, settings.cpp, settings.h]
2026-05-25 v2.0.0 polish: remove orphan dead-zone constants + sync S/M docs
    Pre-flash audit caught:
    - config.h had 3 orphan CLUSTER_DEAD_ZONE_* defines (used only by the
    dead-zone-aware mapping branch removed in v2.0). Deleted.
    - BOT32.ino header comment still said "lever S/M/N" for BOOST mode.
    Fixed to "S/M".
    - settings.cpp default comment still said "S/M/N lever". Fixed to "S/M".
    - settings.h tx_rate_hz comment said "default 20" (was bumped to 30 in
    v1.5.2). Updated.
    - README.md "What it does" / state machine table still said S/M/N + 20Hz
    + "dead zone skip". Updated to S/M + 30Hz + "linear mapping".
    - docs/preflight_checklist.md said "S/M/N". Fixed to S/M.
    No functional c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
    [BOT32.ino, config.h, settings.cpp, settings.h]
2026-05-26 Add DBC + SavvyCAN capture guide for VW MQB powertrain Haldex hunt
    Two new docs for the user's pre-MITM reconnaissance phase:
    - docs/vw_mqb_powertrain.dbc — Partial DBC file with known MQB powertrain
    IDs (HALDEX_GEN5 0x118, MOTOR_11/12, ESP_14/19, WBA_03, MOTOR_04,
    Klemmen_Status_01, etc.) including decoded signals for the critical
    ones (Haldex pump engagement %, state bitfield, wheel speeds, RPM,
    lever position). Load into SavvyCAN with File -> Load DBC File.
    - docs/savvycan_capture_guide.md — Step-by-step capture workflow with
    4 scenarios (baseline / lever scan / throttle blips / driving) so
    the user can confirm the Haldex broadcasts on the powertrain CAN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
2026-05-26 DBC: enrich with vehicle-confirmed signals from 7-capture analysis
    7-capture analysis session on 2026-05-26 (idle, throttle blips, lever
    scan, R/D maneuvers, drive run, TC button, Hazard button) confirmed
    several decodings. Updated DBC with:
    - ESP_21 (0x0FD) byte 6 = TC button state (0x00 enabled / 0x03 off)
    - Blinkmodi_01 (0x366) byte 2 bit 4 = Hazard active, byte 3 = pattern
    - ESP_05 (0x106) byte 3 = brake state (0x00 released / 0x04-05 pressed)
    - GETRIEBE_11 (0x0AD) byte 7 = DSG engaged position (4 values seen)
    - MOTOR_11 (0x0A7) bytes 6-7 = 16-bit raw torque demand
    (idle ~0x3D97, light blip 0x3DE9, full throttle 0x3E77 confirmed)
    - ESP_19 (0x0B2) wheel speeds with scale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
2026-05-26 v2.1.0 — UDS diagnostic commands (Ethanol, Haldex blockage, Clear DTC)
    4 new vehicle-validated UDS commands added based on user's OEM-tool
    captures (cef.csv, caf.csv, ethanol.csv, haldex degree of blockage.csv):
    READ commands (optional polling, off by default):
    - Ethanol content DID 0xF452 on engine ECU (0x7E0/0x7E8)
    1-byte value, raw*100/255 = % (user observed 11%)
    - Haldex blockage DID 0x2BF3 on Haldex ECU (0x70F/0x779)
    16-bit value, scaled to % (user observed 0-40%)
    CRITICAL FINDING: Haldex ECU IS accessible via OBD2
    -> we can READ pump engagement withou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
    [2.csv, 3.csv, 6.csv, 7.csv, caf.csv, cef.csv, ethanol.csv, haldex clutch pump pwm signal diagport.csv]
2026-05-26 v2.2.0 — Configurable cluster display override (ethanol-in-gear-indicator)
    New experimental feature requested by user: replace the cluster lever
    indicator with a custom value (ethanol % or Haldex pump %) when a
    user-configurable trigger button is pressed.
    New module: cluster_override.h/.cpp
    - Listens for trigger CAN signal (any ID + byte + value pair) on the
    cluster bus.
    - When trigger goes into "pressed" state, starts transmitting a
    modified WBA_03 (0x394) at 40 Hz to dominate the gateway's 20 Hz
    broadcast.
    - Override frame uses configurable byte[1] high nibble (display letter)
    + encodes value-pct into byte[3] low nibble (capped 0..14).
    - Properly applies MQB CRC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
    [BOT32.ino, serial_proto.cpp, settings.cpp, settings.h]
2026-05-26 v2.2.1 — Bench test slider + force-override for cluster display
    User request: test the cluster ethanol-display on bench BEFORE going to
    vehicle. Adds a slider (0..100%) for the value to display and a "Force
    override TX" checkbox that bypasses trigger detection so the cluster
    shows the value directly when bench mode is on.
    2 new settings:
    - bench_display_value_pct (uint8, default 11 = user's measured ethanol)
    - bench_force_override (bool, default false)
    cluster_override.cpp behavior:
    - When bench_test_enabled && bench_force_override: trigger is forced
    "pressed" regardless of actual TC button state.
    - When bench_test_enabled: source value = bench_display_value_pct
    (bypasses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
2026-05-26 v2.3.0 — Raw ethanol % display (1:1) + suppress P/R/N/D/S/M letters
    User requested:
    - Real ethanol = 0-100%, want cluster to show 1%, 2%, 3%, ..., 100%
    - Or fallback E1, E2, E3 (NOT P/R/N/D/S/M which are confusing with real gears)
    - New setting: display_byte3_value_mode (uint8 enum)
    0 = RAW : send val_pct as full byte (e.g. 11% -> 0x0B in byte[3])
    1 = ÷7 : legacy v2.2.x behavior (capped 0-14)
    2 = TENS : (val_pct / 10) in low nibble (0-10)
    3 = UNITS : (val_pct % 10) in low nibble (0-9)
    Default = 0 (RAW) for natural 1:1 mapping.
    - Changed default display_override_byte1_high from 0x40 (=D) to 0x00 (blank)
    to avoid P/R/N/D/S/M confu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
    [BOT32.ino, serial_proto.cpp, settings.cpp, settings.h]
2026-05-26 v2.3.1 — UI cleanup: remove all version refs from labels (only boot info)
    User confusion: opened file/UI and saw "v2.2" labels while their actual
    firmware version is v2.3.0. The "v2.2" tags were FEATURE-ADDED-AT markers
    inside section titles that I forgot to update.
    Fix: removed ALL version refs from user-visible UI text. The single
    source of truth for version is now the boot info pill at the top of
    the page ("Booted v2.3.1 (build date)"), populated from BUILD_VERSION.
    - "🧪 Diagnostic OBD2 (v2.1)" -> "🧪 Diagnostic OBD2"
    - "🎨 Cluster display override (v2.2)" -> "🎨 Cluster display override"
    - "🎨 Test cluster display override (v2.2.1)" -> "🎨 Test cluster dis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
    [BOT32.ino, serial_proto.cpp]
2026-05-26 v2.3.2 — HOTFIX: compile bug in cluster_override.cpp ('digit' not declared)
    CRITICAL: v2.3.0 and v2.3.1 did NOT compile. When I introduced the
    display_byte3_value_mode switch in v2.3.0, I renamed the local variable
    'digit' to 'encoded' in the switch block but forgot to update the
    'f.data[3] = digit;' line below. Both versions had this dead code path
    and the compiler rejected the file.
    User caught this when their IDE flashed an OLDER cached build but reported
    the compile error.
    Fix:
    - cluster_override.cpp:122 : f.data[3] = digit -> f.data[3] = encoded
    Version markers bumped to v2.3.2:
    - BOT32.ino line 2
    - BOT32-Haldex.ino line 2
    - BUILD_VERSION (serial_proto.cpp)
    No other firmwa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
    [BOT32.ino, serial_proto.cpp]
2026-05-26 v2.3.3 — UI restructure: live values consolidation + safety hardcode
    Per user feedback — major UI cleanup with fewer distractions:
    UI changes (index.html + app.js):
    1. État live grid expanded from 4 -> 6 cells:
    - Added ⛽ Ethanol content (with inline poll toggle)
    - Added 🏁 Haldex pump engagement (with inline poll toggle)
    Both are now visible at top of page alongside Lever/MAP/Coolant/Real coolant.
    2. Removed entire "Diagnostic OBD2" section. Its only useful element
    (Clear Engine Fault button) is now in the page HEADER, next to
    Push all settings and the connection pill.
    3. Removed "Clear DTC on ALL modules" button entirely from the UI.
    Firmware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
2026-05-26 v2.4.0 — Header redesign, polls ON by default, Clear Engine Fault to roadmap
    4 user-requested changes:
    1. CONNECTION CONTROLS MOVED TO HEADER
    - Port dropdown, Refresh/Connect/Disconnect buttons all in header.
    - 🔌 Connexion section removed from page body.
    - Boot info hidden placeholder kept for null-safety.
    2. CLEAR ENGINE FAULT MOVED TO ROADMAP SECTION
    - Removed from header.
    - New section card in Roadmap: "🔧 Clear Engine Fault (Manual works · Auto-trigger roadmap)"
    - Manual button still works (sends OBD-II Mode 04 broadcast as before).
    - Added 4 trigger-config fields (CAN ID, byte idx, rest, pressed values)
    so the user can configure which physical button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
    [BOT32.ino, serial_proto.cpp, settings.cpp, settings.h]
2026-05-26 v2.4.1 — Roadmap removed + CAN addresses in all 6 live cells
    3 UI changes per user feedback:
    1. Removed "Clear DTC via combo MFSW" section entirely.
    Not pursuing this feature — section deleted with no replacement.
    2. Moved "Clear Engine Fault" from Roadmap into Configuration section.
    It's now a regular collapsible card in the Configuration group:
    - Manual button (works today)
    - cef_trigger_* config fields (firmware auto-trigger still roadmap)
    The Roadmap section header (h2) is gone entirely now that there's
    nothing in it.
    3. Replaced the dynamic "polling OFF ou pas de réponse" / "no data" /
    "stale" / "TX inactif" text under each of the 6 live cells with a
    STAT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
    [BOT32.ino, serial_proto.cpp]
2026-05-26 v2.5.0 — End-of-day checkpoint after complete review
    Final review of all today's changes confirmed:
    ✅ All firmware symbols cleanly declared (no orphan vars after v2.3.2
    'digit' hotfix)
    ✅ Settings struct 100% symmetric across all 39 fields
    (struct ↔ defaults ↔ load ↔ setter ↔ reset ↔ emit ↔ accept)
    ✅ All UI ↔ firmware key wiring intact
    ✅ All HTML element IDs resolve in JS (null-safe handlers for legacy)
    ✅ Version markers aligned everywhere (BOT32.ino, BOT32-Haldex.ino,
    BUILD_VERSION, SETTINGS_VERSION 13, git tag)
    ✅ No regression in boost-on-coolant feature (linear mapping, S/M
    trigger, MAP polling, Motor_09 TX)
    3 minor doc polish c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
    [BOT32.ino, serial_proto.cpp, settings.h]
2026-05-27 v2.5.1 — Clear Engine Fault enable toggle + Hazard 3x4s defaults + CAN section merge
    3 user-requested changes:
    1. CEF AUTO-TRIGGER ENABLE CHECKBOX
    New setting cef_auto_enabled (default true). When OFF, the firmware
    detector (when implemented) won't react to the trigger. UI checkbox
    right above the trigger config block.
    2. NEW DEFAULTS: HAZARD BUTTON, 3 ON/OFF CYCLES IN 4 SECONDS
    - cef_trigger_can_id: 0x0FD (TC) -> 0x366 (Hazard)
    - cef_trigger_byte_idx: 6 -> 2
    - cef_trigger_pressed_value: 0x03 -> 0x10 (Hazard ON bit)
    - 2 new settings to define the multi-press detection sequence:
    cef_press_count (default 3) — number of ON/OFF cycles required
    cef_press_w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
    [BOT32.ino, serial_proto.cpp, settings.cpp, settings.h]
2026-05-27 v2.6.0 — WiFi AP mode for phone access (USB-C path unchanged)
    New optional feature: ESP32 broadcasts a WiFi Access Point that serves a
    mobile-friendly HTML page. User connects phone to "BOT32" SSID, browses
    to http://192.168.4.1, sees live data + can trigger Clear Engine Fault.
    USB-C serial path is 100% UNCHANGED — this is purely additive. Both paths
    work in parallel when WiFi is enabled.
    New module: wifi_ui.h/.cpp
    - Lazy-start: AP only comes up if settings.wifi_enabled = true
    - Uses built-in WebServer.h (no extra Arduino lib needed)
    - Coexists with Haldex ESP-NOW: if haldex_transport=1 AND wifi_enabled=true,
    uses WIFI_AP_STA mode to support both.
    - Routes:
    GET /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
2026-05-27 v2.6.1 — Fix password change + live wifi status + mobile settings page
    3 user-reported issues fixed:
    1. PASSWORD CHANGE WAS IGNORED
    wifi_ui_apply() compared only the SSID before deciding to restart the
    AP — so password edits silently no-op'd because SSID didn't change.
    Fix: always tear down + restart when wifi_ui_apply() is called and
    wifi_enabled is true. Brief WiFi outage (~150ms) on credential change
    is acceptable.
    2. WIFI LIVE STATUS NEVER UPDATED
    wifi_active / wifi_ip / wifi_clients were emitted in emit_settings()
    (only fires on settings change), not emit_status() (fires every 500ms).
    So the PC UI's "WiFi remote" status pills stayed at "—".
    Fix: moved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
    [BOT32.ino, serial_proto.cpp, serial_proto.h, wifi_ui.cpp]
2026-05-27 v2.7.0 — Ethanol + Haldex polled live in ALL lever positions
    User request: stream ethanol % and Haldex pump engagement % live on
    both PC web UI (USB-C) and mobile UI (WiFi) regardless of gear lever
    position, not just S/M (BOOST mode).
    Implementation:
    Single-line behavior change in BOT32.ino loop. The obd2_tick() gate
    now activates the UDS polling round-robin whenever poll_ethanol OR
    poll_haldex_blockage settings are enabled (both default true since
    v2.4.0), not only when currentMode == MODE_BOOST.
    Before (v2.6.1):
    obd2_tick(currentMode == MODE_BOOST || settings_get().force_tx_always);
    After (v2.7.0):
    bool obd2_active = (currentMode == MODE_BOOST)
    |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
2026-05-31 v2.7.1 — Bench mode UX: auto TX toggle + jumper warnings
    User-reported issue: bench mode silently does nothing if tx_enabled is
    OFF (master switch). User wasted time debugging why the cluster didn't
    animate. Plus bench requires manual jumper repositioning on the HAT
    (120Ω terminators ON for bench, OFF for vehicle install) which is easy
    to forget.
    Fix in 2 layers:
    1. FIRMWARE — auto-manage tx_enabled on bench transitions
    New setting tx_enabled_before_bench (bool, default true) memorizes
    the user's tx_enabled state at the moment bench is activated.
    settings_set_bench_test_enabled() now handles the transition:
    - Entering bench (false→true): save tx_enabled → tx_enabled_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
    [BOT32.ino, serial_proto.cpp, settings.cpp, settings.h, wifi_ui.cpp]
2026-05-31 v2.8.0 — DSG/Engine oil/EGT temps + Hand brake + OK MFSW button
    Adds 5 new live values to PC + mobile UI, all bench/vehicle-validated
    from fresh SavvyCAN captures on Alltrack 2017 (2026-05-26):
    UDS polled (engine + transmission ECUs):
    - DSG oil temp DID 0x2104 (TCM 0x7E1/0x7E9, byte4 = degC)
    - EGT DID 0x40D5 (engine 0x7E0/0x7E8, raw_BE - 250)
    - Engine oil temp DID 0xF43C (engine 0x7E0/0x7E8, byte5 - 8)
    Cluster-bus passive sniffers (no TX, no firmware action):
    - Hand brake 0x30B (KOMBI_01) byte[2] bit 7
    - OK MFSW button 0x5BF byte[0] = 0x00
    Per user choice "Live data grid uniquement", no UI toggles are added —
    the 3 new DIDs are always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
2026-05-31 v2.9.0 — +Hazard/TC sniffers, -cluster display override
    Adds 2 new live cells (PC + mobile UI) and removes one obsolete feature.
    ADD — 2 new button sniffers (passive, cluster bus):
    - Hazard switch 0x366 (Blinkmodi_01) byte[2] bit 4 = 0x10 ON
    - Traction Control 0x0FD (ESP_21) byte[6] = 0x03 pressed
    These are decoded in button_sniffer (alongside Hand brake + OK MFSW from
    v2.8.0). All four sniffers register one cluster-bus listener; no extra
    firmware logic, no TX, no user-facing toggle — just live display.
    REMOVE — cluster_display_override feature (entire v2.2-v2.8.0 module):
    - Deleted BOT32/cluster_override.cpp + cluster_override.h
    - Removed cluster_overri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
2026-05-31 v2.10.0 — remove engine oil temp; TC shows ON/OFF; fix OK button decode
    - Engine oil temperature (DID 0xF43C) removed completely: poll slot, getter,
    status emit, PC + mobile UI cells. Round-robin reduced 6 -> 5 slots.
    - Traction Control live status now displays ON (released = TC active) /
    OFF (button held = TC disabled), on PC and mobile.
    - Fix OK button (0x5BF): idle/rest state is 0x00; pressed = byte[0] != 0x00.
    Previous code tested == 0x00, so it reported pressed while idle.
    - SETTINGS_VERSION unchanged (18) -> user settings preserved on reflash.
    - Update CLAUDE.md + ETAT_DU_PROJET.md.
    [BOT32.ino, button_sniffer.cpp, button_sniffer.h, config.h, obd2.cpp, obd2.h, serial_proto.cpp, wifi_ui.cpp]
2026-05-31 v3.0.0 — stable release (all features confirmed working on bench)
    Version bump to v3.0.0 across all markers (BOT32.ino, BOT32-Haldex.ino,
    BUILD_VERSION, wifi_ui handle_status). No functional code change since v2.10.0;
    this milestone marks every feature confirmed working on the bench, including
    the corrected OK button (0x5BF) decode. SETTINGS_VERSION unchanged (18).
    Updated ETAT_DU_PROJET.md tracking doc.
    [BOT32.ino, serial_proto.cpp, wifi_ui.cpp]
2026-05-31 chore: move BOT32-Haldex MITM to a separate private repo (BOT32-HALDEX)
    - The Haldex MITM sketch is removed from this public MIT repo; it has been
    ported to the Autosport Labs ESP32-CAN-X2 and now lives in a private repo
    (ALagrandeur/BOT32-HALDEX, ESP-NOW link only).
    - The client side stays here (haldex_link / haldex_espnow) plus the public
    protocol doc (docs/haldex_integration.md).
    - Updated CLAUDE.md + ETAT_DU_PROJET.md to reflect the move.
    - Main BOT32 firmware unchanged (v3.0.0).
2026-05-31 v3.1.0 — Haldex modes (main side): ESP-NOW-only, 3 modes, combo FWD
    - New haldex_modes module: decides STOCK/FWD/50-50 and pushes to the MITM (X2).
    - FWD armed by physical combo (Hazards ON + TC button) via existing sniffers;
    exits when hazards turn OFF. Also settable from app/USB.
    - 50/50 from app/USB only; exits via STOCK button. NO timed auto-revert.
    - Haldex link is now ESP-NOW ONLY (CAN transport removed from haldex_link +
    UI). Settings struct unchanged -> SETTINGS_VERSION stays 18 (no NVS reset).
    - WiFi: phone AP + ESP-NOW coexist, locked to channel 1 (WIFI_AP_CHANNEL).
    - serial_proto + wifi /api/cmd route set_haldex_mode through haldex_modes.
    - Status JSON adds haldex.onli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
    [BOT32.ino, config.h, haldex_link.cpp, haldex_modes.cpp, haldex_modes.h, serial_proto.cpp, wifi_ui.cpp]
2026-05-31 v3.1.0 fix: mobile /api/status Haldex block + .race-btn.active CSS
    Two edits had silently failed in the v3.1.0 commit:
    - handle_status (mobile) now includes the haldex{} object (online, local_mode,
    speed, pedal, target, pump) so the mobile Haldex live cells populate.
    - Added .race-btn.active outline so the active mode button is highlighted (PC).
    [wifi_ui.cpp]
2026-05-31 v3.2.0 — Haldex cleanup + passthrough ON/OFF + Phase 2 (armed MITM on X2)
    Cleanup (removed dead CAN-transport settings — ESP-NOW is the only transport):
    - Dropped haldex_bus / haldex_state_id / haldex_cmd_id / haldex_transport from
    the settings struct + all 7 layers (defaults, NVS load/save, setters, JSON,
    dispatcher, PC + mobile UI). SETTINGS_VERSION unchanged (18): old NVS keys are
    left orphaned (harmless), so user settings are preserved (no reset).
    - Removed unused 6040/7525/Expert mode enum values; haldex_mode_name -> 3 modes.
    New — Passthrough ON/OFF (MITM arming):
    - set_haldex_passthrough command (serial + wifi /api/cmd) -> ESP-NOW 0x03.
    - haldex_modes_set_passthrough/get_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
    [BOT32.ino, haldex_espnow.cpp, haldex_espnow.h, haldex_link.cpp, haldex_link.h, haldex_modes.cpp, haldex_modes.h, serial_proto.cpp]
2026-05-31 v3.3.0 — UI shows the X2's actual (persisted) Haldex mode
    Pairs with BOT32-HALDEX v0.3.0 (X2 now persists mode + passthrough across
    reboots). The live 'Mode' cell + button highlight now follow the mode REPORTED
    by the X2 (hx.current_mode) when the link is online, falling back to the
    locally-commanded mode when offline — so the UI stays truthful after an
    autonomous X2 reboot. Mobile status JSON now includes haldex.current_mode.
    Docs (CLAUDE.md, ETAT_DU_PROJET.md) updated.
    [BOT32.ino, serial_proto.cpp, wifi_ui.cpp]
2026-05-31 docs: document FWD burnout wheel-speed spoof (X2 v0.4.0)
    CLAUDE.md + ETAT_DU_PROJET.md note the ESP_19 (0x0B2) wheel-speed spoof the X2
    applies in FWD burnout, and that it only fools the Haldex (ESP/ABS upstream is
    defeated via the TC/ESP-off button). No firmware change in the public repo
    (main BOT32 unchanged at v3.3.0).
2026-05-31 docs: fix stale haldex_link.h header (was CAN 0x6B0/0x6B1 + 6 modes)
    The header still described the OLD architecture (CAN transport on 0x6B0/0x6B1,
    6 modes incl. 6040/7525/Expert) which directly contradicted the actual code
    (ESP-NOW only, 3 modes STOCK/FWD/5050, + SET_PASSTHROUGH). Rewrote it to match.
    No code change.
    [haldex_link.h]
2026-05-31 docs(ui): fix stale Haldex architecture text (was CAN 0x6B0/0x6B1)
    The PC UI 'Architecture' panel still told the user the link used CAN broadcast
    0x6B0 / command 0x6B1. Rewrote it for the real architecture: ESP-NOW only
    (channel 1), STATE / SET_MODE / SET_PASSTHROUGH, ESP32-CAN-X2 MITM. No code change.
2026-05-31 v3.4.0 - bench lamp killer: live-toggleable status-frame injector
    Goal: extinguish cluster warning lamps on the bench by replaying healthy-bus
    status frames, and let the user map which frame clears which lamp - live, no reflash.
    - NEW bench_frames.{h,cpp} (GENERATED): 43 candidate periodic status frames with
    steady-state payloads + periods derived from the real capture
    "OFF to start cluster.csv" (lights end OFF). 10 of them carry an MQB E2E
    CRC+counter whose per-ID magic tables are DERIVED from the capture. CRC
    regenerated on the fly; module keeps its own magic tables + reuses the global
    MQB_CRC8H2F (no vw_mqb edit).
    - All frames default DISABLED at boot (nothing emitted). Sent on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
2026-05-31 v3.4.1 - bench lamp killer: add SLOW status frames + fix non-ASCII label
    Two fixes after the first bench test:
    1) The v3.4.0 generator dropped any ID seen < 50 times in the 15s capture, which
    silently excluded all ~1-2 Hz status frames (0x5xx/0x6xx) that drive the
    Check Engine, power-steering "!", TPMS and yellow-triangle telltales. Replaced
    the raw-count cutoff with a "periodic across the whole capture" test: 43 -> 80
    candidate frames, 10 -> 11 CRC tables (new 0x3D4). New UI group
    "Lent (>=400ms) - Check Engine/EPS/TPMS?".
    2) The generator emitted an em-dash in C string labels which, written on Windows,
    corrupted to invalid bytes inside a string serialized to JSON over ser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
    [BOT32.ino, serial_proto.cpp, wifi_ui.cpp]
2026-05-31 v3.5.0 - lamp test moved into bench card + onboard LED shows X2 link
    1) PC UI: the "Test voyants" (lamp-killer) injector is now built INSIDE the
    bench-test card body (.card-bench .collapsible-body) instead of a standalone
    card - the two features work together. Rendered as a sub-section, with a
    fallback to <main> if the bench card isn't found.
    2) Onboard status LED (GPIO2) now reports the X2 ESP-NOW link WHEN the Haldex
    link is enabled: solid ON = connected (STATE fresh < HALDEX_LINK_STALE_MS),
    slow blink (400ms) = searching/disconnected. When Haldex is disabled the LED
    keeps the normal mode indication (BOOT/SILENT/BOOST/BENCH/SAFE_FAULT).
    (Point "block all TX unless bench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
2026-06-01 v3.6.0 - bench: identified-telltale group + labels + km/h speedo slider
    1) Lamp-killer UI: the 4 telltales identified on the bench are now grouped under
    "Voyants identifies" with their description shown (highlighted), so they're easy
    to find:
    0x31B - Traction control + ABS + frein rouge (cadran RPM)
    0x656 - Defaillance direction (cadran RPM)
    0x64A - TPMS (cadran RPM)
    0x394 - Shift lock / appuyer sur le frein (cadran km/h)
    Generator: KNOWN{} map -> per-frame label + forced group; struct gains a label
    field; bench_frames_label() accessor; serial JSON + app.js show it.
    2) New km/h speedometer slider in the bench card. Drives ESP_21 (0x0FD) bytes 4-5
    (x0.01 km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
2026-06-01 v3.6.1 - fix lamp-test UI (const reassign) + discoverability hint
    - app.js: updateCount() had a `const el = ...; el = ...` reassignment
    (TypeError at runtime). Removed the stray line. The lamp-test card is built
    inside the bench card's collapsible body and only appears once the PC is
    connected to a v3.4.0+ ESP32 AND the bench card is expanded.
    - index.html: bench card summary now mentions "Test voyants (cliquer pour
    deplier)" so the moved sub-section is discoverable (the bench <details> is
    collapsed by default).
    Web-UI only; bumped version markers to v3.6.1 to keep them uniform. No firmware
    logic change. SETTINGS_VERSION unchanged.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
    [BOT32.ino, serial_proto.cpp, wifi_ui.cpp]
2026-06-01 v3.6.2 - fix km/h speedo (dual ESP_21+ESP_24) + lamp-killer = identified only
    1) Speedometer now works. Root cause of the dead slider: the MK7 needle needs
    TWO frames sent in PARALLEL (r00li recipe, proven in mk7-cluster-bench-controller):
    0x0FD ESP_21 bytes 4-5 LE = round(km/h * 98.5) (was wrongly x100, single frame)
    0x31B ESP_24 bytes 2-3 LE = round(km/h * 1.35 * 100)
    Both share one rolling counter. Added the 0x31B (ESP_24) MQB CRC magic table
    to vw_mqb.cpp. The 0x31B payload reuses this car's real captured steady-state
    (67 06 .. .. 00 00 00 7E) so it also keeps TC/ABS/brake lamps off.
    ESP_21 template fixed to 00 D0 1F 80 .. (was 0B D0 1F 80 ..). Rate 20 Hz.
    2)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
    [BOT32.ino, bench_test.cpp, serial_proto.cpp, vw_mqb.cpp, wifi_ui.cpp]
2026-06-02 v3.7.0 - DEV: direct USB-C connection to the X2 (PC only)
    Adds a Haldex connection-source selector in the PC web UI so the X2 can be
    driven DIRECTLY over a 2nd USB-C serial port during development/diagnostic,
    bypassing ESP-NOW + the main module. No duplicated logic: the X2 reuses its
    existing core (mode_state / haldex_mitm) behind a thin serial facade.
    webui/server.py:
    - Optional 2nd serial link (X2) + its own reader thread.
    - haldex_source = "espnow" (default/normal) | "usbc" (dev). Persisted in
    config.json.
    - When source=usbc: set_haldex_mode / set_haldex_passthrough route to the X2;
    the X2's haldex_state is injected into status.haldex so the existing UI
    renderer works u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
2026-06-05 webui: show MCP2515 TEC (TX error counter) + flag MCP bus-off in the Haldex CAN cell
    Surfaces hdx_tec/hdx_eflg from the X2 (v1.4.4). TEC is an early warning: it climbs
    on accumulating CAN bit errors (marginal Haldex-side termination) before the MCP
    goes bus-off. The cell turns red on dropped frames, TEC>96, or a set error flag.
    [server.py]
2026-06-05 webui: route Haldex cmds to MAIN serial as fallback when the X2 dev link isn't open
    Fixes 'mode/passthrough buttons do nothing' when server.py auto-detected the X2 as
    the MAIN port (no --x2-port) while source=usbc: send_cmd_x2 failed (x2_ser None) and
    the command was dropped. Now falls back to send_cmd (the MAIN, where the X2 is) so
    the command reaches it either way.
    [server.py]
2026-06-05 webui: forward X2 command ack to the UI + show 'applied' near the Haldex buttons
    Completes the fix so mode/passthrough commands clearly work from the interface:
    server.py forwards the X2's {evt:ack} (and pong); app.js shows '✓ appliqué par le
    X2' (green) or the error (red) next to the buttons, and the live mode/passthrough
    cells reflect the new state from the next haldex_state.
    [server.py]
2026-06-05 v3.8.0: lock ESP-NOW radio channel on main + RX diagnostics
    The X2 hard-locks its radio to channel 1 (esp_wifi_set_channel) but the main
    did not — it relied on the phone AP (started later) to pin the channel. With
    the AP OFF, the main could sit on a different channel than the X2 and never
    receive its broadcast STATE (UI shows STOCK + '—'). Fix: the main now locks
    ESPNOW_CHANNEL explicitly in haldex_espnow_init(), exactly like the X2, so the
    link works whether the AP is on or off (WIFI_AP_CHANNEL == ESPNOW_CHANNEL).
    Also adds an ESP-NOW RX counter: serial prints 'first STATE received from X2 —
    link UP' on the first packet, and the count is exposed as haldex.espnow_rx in
    the status JSON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
    [BOT32.ino, haldex_espnow.cpp, haldex_espnow.h, serial_proto.cpp, wifi_ui.cpp]
2026-06-05 webui: prominent main<->X2 ESP-NOW link banner in the Haldex card
    Adds a big colour-coded banner that says, in plain language, whether the two
    ESP32s actually see each other — driven by haldex.espnow_rx + online + the
    selected source:
    - green : the 2 ESP32 are connected (N frames received from the X2)
    - red : they do NOT see each other (0 frames) — with what to check
    - red : main not connected to the PC (ESP-NOW path is the main)
    - orange : link lost (was up, X2 now silent — asleep/out of range)
    - orange : main on old firmware (no espnow_rx field -> flash v3.8.0)
    - usb-c : direct X2 link, ESP-NOW bypassed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
2026-06-05 v3.9.0: disable WiFi power-save for a solid ESP-NOW link + channel readback
    Root cause of the dead main<->X2 link (even with channels matched on 1): the
    main never disabled WiFi modem power-save. With the phone AP OFF the main is
    STA-only and the radio naps between beacons, DROPPING the X2's broadcast STATE
    — the classic 'ESP-NOW not receiving' bug. Fix: WiFi.setSleep(false) +
    esp_wifi_set_ps(WIFI_PS_NONE) in haldex_espnow_init(), re-asserted in
    wifi_ui_apply() after the AP_STA mode switch (which silently re-enables PS).
    Also prints the ACTUAL radio channel at init to confirm both ends are on 1.
    [BOT32.ino, haldex_espnow.cpp, serial_proto.cpp, wifi_ui.cpp]
2026-06-05 docs: v3.9.0 save point — ESP-NOW link solid + MITM confirmed in-vehicle
    Update ÉTAT_DU_PROJET, CLAUDE.md and haldex_integration.md to the current state:
    - versions v3.9.0 (main) / v1.5.0 (X2)
    - ESP-NOW reliability writeup (channel lock + WiFi power-save OFF on both ends)
    - corrected MITM facts: full frame set (0x08A/0x0A7/0x0A8/0x116/0x106/0x0B2),
    CRC DataID APPENDED, 50/50 demand 0xFA (not 0xFE), in-vehicle confirmation
    - termination guidance corrected to TERM2 enabled + bench diagnostics
2026-06-05 v3.10.0: optional FWD cluster telltale — blink WBA_03 (0x394) shift-lock in FWD
    Adds an opt-in visual FWD indicator: when haldex_fwd_telltale is ON and mode ==
    FWD, BOT32 main blinks the WBA_03 (0x394) 'shift lock — press brake' message on
    the km/h dial (0.5 s), reusing the existing haldex_modes blink phase. TXes at
    ~40 Hz during the blink-ON phase to dominate the gateway's ~20 Hz (same approach
    as the old display override), silent during OFF so the gateway's normal gear
    display resumes -> the message blinks.
    - New setting haldex_fwd_telltale (default OFF, NVS key 'hdx_tt', NO settings
    version bump -> existing user config preserved since NVS uses per-key storage)
    - Frame built with vw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
2026-06-05 Revert "v3.10.0: optional FWD cluster telltale — blink WBA_03 (0x394) shift-lock in FWD"
    This reverts commit 464d46ff74b14306f3c4b979a3a88c6679f3c3f4.
    [BOT32.ino, haldex_modes.cpp, serial_proto.cpp, settings.cpp, settings.h, wifi_ui.cpp]
2026-06-06 v3.10.0: FWD exits on TC re-enabled (not on hazards OFF)
    Per user request, flip the FWD release condition. The arming combo is unchanged
    (Hazards ON + TC OFF, rising edge), but FWD now stays armed while traction
    control is OFF and drops back to STOCK only when TC is turned back ON — so the
    hazards can be switched off while FWD stays active.
    Confirmed on the live data that 0x0FD byte6==0x03 is the LATCHED TC-disabled
    state (stays set after the button is released), so button_sniffer_tc_pressed()
    is a stable hold signal — no new capture needed. Hazards ON remains the
    deliberate arming gate (disabling TC alone never arms FWD). Losing the TC frame
    (stale) drops to STOCK as a safe default.
    C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
    [BOT32.ino, haldex_modes.cpp, haldex_modes.h, serial_proto.cpp, wifi_ui.cpp]
2026-06-06 v4.0.0: stable milestone — full in-vehicle Haldex MITM + boost gauge + diagnostics
    Major version: everything confirmed working in-vehicle by the driver. Bundles the
    recent fixes since v3.9.0:
    - v3.10.0: FWD exits on TC re-enabled (not hazards OFF) — latched TC state
    - (X2 v1.6.0): 0x0A8 passthrough — D8 is the engine-RPM signal, not the lock
    demand; lock demand lives only in 0x08A D8 + 0x0A7 D6/D7. Kept 0x08A D8 = 0xFA
    (this car never exceeds 0xFA on the real bus; 0xFE is SNA — not OpenHaldex's 0xFE)
    Docs fully refreshed: ÉTAT_DU_PROJET, CLAUDE.md, docs/haldex_integration. Pending
    work (captures): Haldex 50/50 driving log + cluster telltale on/off payloads.
    Pairs with BOT32-HA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
    [BOT32.ino, serial_proto.cpp, wifi_ui.cpp]
2026-06-08 v4.1.0: UI — CAN source labels on Haldex live cells + mobile layout polish
    PC + mobile:
    - Add the CAN source (pale gray) under each Haldex live cell, like the cluster/
    diagnostic cells (0x118 pump, 0x0FD speed, 0x121 pedal, etc.).
    Mobile only:
    - Haldex live grid is now a clean symmetric 8-card layout; passthrough status is
    its own tappable box (tap to arm/disarm) — replaces the separate button; added
    a 'Dernier paquet' (link freshness) card as the 8th.
    - Mode buttons (STOCK/FWD/50-50) get top spacing + are centered, so they no
    longer crowd the last live param.
    - 'Clear Engine Fault' button moved from the main page into the settings page.
    No behaviour change. Pedal % verified co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
    [BOT32.ino, serial_proto.cpp, wifi_ui.cpp]
2026-06-13 docs: Haldex 50/50 milestone — holds ~95% at all speeds (X2 v3.0.0)
    50/50 is solved in-vehicle. The Gen5 Haldex de-rates the lock as vehicle speed rises;
    the X2 now makes it believe the car is stationary + idling so it holds ~95% engagement
    at every road speed (was fading to ~0 by 60 km/h). Updated ÉTAT_DU_PROJET.md (milestone
    + steering-angle-kept-on-purpose + pending oil-temp auto-revert) and
    docs/haldex_integration.md (frame-role table + the v3.0.0 breakthrough note).
    Public-repo docs kept at the conceptual level — exact spoof values + DataID tables stay
    in the private BOT32-HALDEX firmware.
2026-06-13 v4.2.0 — mobile UI: clutch temp cell + armed-status header badge
    Two mobile-UI changes requested by the user, both clean (X2 unaffected — UDS bridges
    through it transparently, already proven by the blockage poll):
    1. CLUTCH TEMP. New DID 0x2BF1 on the Haldex ECU (0x70F/0x779), decoded from a real
    capture: resp 05 62 2B F1 <status> <temp>, temp_C = data[5]*0.75-48 (standard VAG
    temp scale; data[5]=0x64=100 read ~28.5C cold — CALIBRATE vs VCDS). Added as poll
    slot 5 (N_POLL_SLOTS 5->6, gated on poll_haldex_blockage, same ECU) + cache +
    getters + stale timeout + JSON fields. Replaces the 'Dernier paquet' card in the
    mobile Haldex grid with 'Temp embrayage' (0x2BF1).
    2. AR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
    [BOT32.ino, config.h, obd2.cpp, obd2.h, serial_proto.cpp, wifi_ui.cpp]
2026-06-13 v4.3.0 — Haldex clutch thermal cut-out (auto-revert to STOCK over-temp)
    Adjustable clutch-temp limit (default 150C) in 'Tous les reglages'. When the Haldex
    clutch oil temp (UDS 0x2BF1, v4.2.0) reaches the limit, haldex_modes forces STOCK and
    LATCHES there (blocking any re-arm, incl. the FWD hardware combo) until it cools by
    10C hysteresis. This protects the clutch since the speed-spoof 50/50 bypasses the
    Haldex's own speed-based thermal protection.
    - settings: new haldex_clutch_temp_limit_c (uint16, default 150, clamp 60..250) +
    getter/setter/NVS. NO SETTINGS_VERSION bump on purpose — getUShort(key,150) handles
    the missing key on existing installs, so the user's paired X2 MAC + WiFi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
    [BOT32.ino, haldex_modes.cpp, haldex_modes.h, serial_proto.cpp, settings.cpp, settings.h, wifi_ui.cpp]
2026-06-13 v4.3.0 audit fix: clutch-temp-limit field in /api/get_settings + docs
    Pre-flash audit caught a UI bug: handle_api_get_settings (the endpoint the settings
    page reads to populate its inputs) did not include haldex_clutch_temp_limit_c, so the
    new limit field would have loaded EMPTY (firmware still defaulted to 150, but the user
    couldn't see/confirm the value). Added it.
    Docs: ÉTAT_DU_PROJET.md bumped to v4.3.0 with the main v4.2.0/v4.3.0 additions (clutch
    temp display, armed-status badge, thermal cut-out, shift-lock telltale dropped);
    docs/haldex_integration.md updated — the Haldex oil-temp auto-revert is now IMPLEMENTED
    (was 'planned'). All version stamps verified (main 4.3.0, X2 3.0.0); t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
    [wifi_ui.cpp]
2026-06-14 v4.4.0 — mobile settings cleanup + clutch-temp raw readout for calibration
    Mobile UI ONLY (settings page /settings):
    1. Removed 'Cluster bus IDs' section entirely.
    2. 'OBD2 bus IDs' -> 'OBD2', keeps only Poll Hz (Req/Resp/DID inputs removed).
    3. 'TX' renamed -> 'Diffusion TX' (contents unchanged).
    4. Removed 'Bench test' section entirely.
    5. 'Clear Engine Fault': kept the manual button, removed the auto-trigger config fields.
    6. WiFi AP: unchanged. 7. Haldex link: unchanged.
    The removed inputs only disappear from the MOBILE page; the underlying settings still
    exist in firmware (still in get_settings JSON + serial), so nothing breaks — they just
    keep their stored/default values. One dead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
2026-06-14 docs: ÉTAT_DU_PROJET to v4.4.0 (settings cleanup + clutch-temp raw calibration readout)
2026-06-15 docs: bring README + future_features + haldex_integration up to date (v4.4.0)
    - README: Haldex modes corrected to the 3 we actually ship (Stock/FWD/50-50, 50-50
    holds ~95% at all speeds) + clutch temp + over-temp auto-revert; added screenshots
    link; boost-on-coolant marked working in-vehicle; roadmap notes Clear Engine Fault
    shipped.
    - future_features.md: status banner — both original 'future' features are now built
    (Feature 1 -> Clear Engine Fault; Feature 2 -> Haldex MITM on the X2).
    - haldex_integration.md: note the raw 0x2BF1 readout in the UI for temp calibration.
2026-06-15 docs: ÉTAT_DU_PROJET — UDS round-robin is 6 slots now (+ Haldex clutch temp 0x2BF1)
2026-06-27 v4.5.0 — FINAL: clutch temp display only (calibrated formula), thermal cut-out removed
    Per the decision to rely on the Haldex's own built-in thermal protection, BOT32 no
    longer adds any over-temp safety — it only DISPLAYS the clutch oil temp.
    - Calibrated formula: temp_C = data[5]*2.7 - 241.5 (vs VCDS: 100->28.5C, 104->39.3C),
    replacing the tentative 0.75*x-48.
    - REMOVED the v4.3.0 thermal cut-out entirely: setting haldex_clutch_temp_limit_c
    (struct/defaults/load/save/setter/dispatch/emit/get_settings/UI field), the
    haldex_modes trip latch + getter (g_thermal_trip, the tick block, obd2.h include),
    and the haldex_thermal_trip status flag + UI 'SURCHAUFFE' badge.
    - REMOVED the v4.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
2026-06-27 docs: align with v4.5.0 — clutch temp is display-only (calibrated formula), thermal cut-out removed (Haldex native protection)
    - README: Haldex link no longer claims an over-temp auto-revert (display only).
    - ÉTAT_DU_PROJET: bumped to v4.5.0; v4.3.0 cut-out + v4.4.0 raw readout entries
    replaced with the final 'display only + calibrated formula data[5]*2.7-241.5'.
    - haldex_integration: same; no BOT32 cut-out, Haldex's own protection relied upon.
    - screenshots gallery: note the shots are v4.4.0 (the temp-limit field + raw readout
    shown there were removed in v4.5.0).
2026-06-27 docs: future_features — Feature 2 banner says clutch temp is display-only (no cut-out)
2026-10-11 v4.6.0 — effacement codes moteur en écoute seule, 50/50 par combo, aide-mémoire
    - Bouton web « Effacer les codes moteur » (cellulaire + PC) : BOT32 passe en
    écoute seule sur les deux bus CAN (can_set_quiet), Haldex remis en STOCK,
    puis OBD-II Mode 04 envoyé au moteur seulement (0x7E0) avec attente de la
    réponse 0x7E8 (0x44 / 7F 04 78 / refus / délai). Résultat affiché sur la page.
    - 50/50 par combo physique : frein à main tiré + Hazard ON + TC OFF (frein
    baissé = FWD). Un mode armé par le combo ne bascule plus tant que le TC
    reste OFF ; TC ON = STOCK. Un STOCK explicite est toujours renvoyé au X2.
    - Aide-mémoire des combinaisons dans l'UI mobile et PC.
    - Bouton Ar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
2026-10-12 docs: README Main ESP v4.6.0, carte des véhicules, docs historiques signalées, webui/README — aucun changement de code
    Claude-Session: https://claude.ai/code/session_01BdrRTYSoy8v67D9bHyU3Lh
2026-10-23 v4.7.0 — effacement des codes moteur au volant (OK × 10 en moins de 6 s)
    - ok_clear.cpp/.h : le bouton OK du volant appuyé 10 fois en moins de 6 s
    lance la procédure d'effacement v4.6.0 (écoute seule, Haldex STOCK, moteur
    seulement) ; 10 s d'inhibition après un déclenchement.
    - button_sniffer : fronts du bouton OK comptés trame par trame
    (button_sniffer_ok_press_events / ok_last_code).
    - obd2 : source de l'effacement (cellulaire / PC / bouton OK) exposée dans le
    status (clear_engine_src).
    - UI cellulaire : bandeau ⏳ / ✓ / ✗ sur la page principale, seulement si elle
    est ouverte au moment de l'effacement ; carte OK × 10 dans l'aide-mémoire.
    - UI PC : résultat affic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
2026-10-23 v4.8.0 — Haldex en STOCK à chaque redémarrage + effacement des codes par OK maintenu 6 s
    - ignition_watch.cpp/.h (nouveau) : STOCK forcé au démarrage de BOT32, à chaque
    changement de contact (Kl15, Klemmen_Status_01 0x3C0 octet 2 bit 1, confirmé
    00 -> 03 par la capture 1.csv) et au réveil du bus cluster après >= 3 s de
    silence. Silence mesuré jusqu'à la dernière lecture CAN (pas de faux réveil
    après une pause de la boucle). Exige la liaison Haldex activée.
    - haldex_modes : haldex_modes_force_stock() renvoie STOCK toutes les 500 ms
    jusqu'à confirmation du X2 (10 s max) ; un mode choisi (app / combo) annule.
    Fraîcheur des trames du combo comptée en temps de lectu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
2026-10-24 v4.8.0 — retour en STOCK assuré par le principal seul (X2 v3.0.0 gardé, pas de reflash)
    Le X2 de la voiture reste en BOT32-HALDEX v3.0.0 : il ne revient jamais en
    STOCK de lui-même (mode en RAM, gardé pendant la veille). Le principal est donc
    le seul filet et doit livrer STOCK à coup sûr.
    - haldex_modes : le STOCK forcé est renvoyé toutes les 500 ms jusqu'à ce que
    le STATE du X2 rapporte STOCK, y compris pendant que le X2 dort (ESP-NOW
    coupé) : il le reçoit ~1 s après son réveil. Abandon après 10 s de liaison
    sans STOCK ou 30 min sans aucun STATE. Seul un STATE reçu après l'envoi
    confirme (un STATE plus ancien peut précéder le changement).
    - Tous les retours en S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
2026-10-24 v4.8.0 — Haldex en STOCK seulement après une coupure de 5 min (plus courte : mode gardé)
    Règle demandée : il faut une coupure assez longue (5-10 min) pour remettre le
    X2 en STOCK ; une coupure de quelques secondes garde le mode actuel du X2.
    - ignition_watch : coupure = contact OFF (Kl15, 0x3C0) ou bus cluster
    silencieux. Coupure < 5 min (contact coupé/remis, calage + redémarrage,
    coupure CAN ou radio) = mode gardé. À 5 min (IGN_LONG_CUT_MS), STOCK tout
    de suite (le X2 est encore éveillé, il ne dort qu'après 15 min sans CAN),
    et de nouveau à la remise du contact si ce STOCK n'a pas été confirmé.
    Plus de STOCK à chaque changement de contact ni au réveil du bus.
    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
2026-10-24 v4.8.0 — textes d'aide : règle des 5 min et sortie TC après un redémarrage
    - Cellulaire et PC : « Au démarrage, toujours STOCK » remplacé par « Auto
    coupée 5 min ou plus : retour en STOCK (coupure plus courte : le mode est
    gardé) ».
    - Carte « Retour STOCK » : après un redémarrage, le TC revient seul à ON sans
    changer le mode — TC OFF puis ON.
    - Visuels validés par l'utilisateur.
    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
2026-10-24 v4.8.0 — effacement des codes : Mode 04 OBD générique (0x7DF, puis 0x700)
    L'effacement ne marchait pas dans l'auto : depuis v4.6.0, le Mode 04 était
    envoyé en adressage physique au moteur (0x7E0). Un effacement OBD générique,
    sans le mode de connexion VW, fonctionne.
    - obd2 : Mode 04 [01 04] en requête fonctionnelle OBD générique sur 0x7DF ;
    si le moteur reste muet 2 s ou répond « non supporté » (0x11/0x12), même
    requête sur 0x700 (adresse de l'outil VW dans cef.csv : 7E8 7F 04 78 puis
    44, 7E9 44). Pas de relance si le moteur a répondu « en attente ».
    - Le moteur décide (0x7E8) ; les 0x44 des autres calculateurs OBD
    (0x7E9 = DSG) sont listés : « Codes effacés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
2026-10-25 v4.8.0 — OK maintenu 6 s : tolérance aux micro-relâchements + diagnostic
    Premier essai en voiture : OK maintenu 6 s n'a rien déclenché (aucun bandeau
    sur le cellulaire). Le comportement réel de la trame 0x5BF pendant un appui
    long n'est pas connu (pas de capture).
    - ok_clear : un relâchement de moins de 250 ms (OK_RELEASE_DEBOUNCE_MS :
    trame qui clignote, code qui change) n'annule plus l'appui ni ne relance
    le compte des 6 s ; la fin du dernier maintien est enregistrée (relache,
    trame perimee, inhibition 10 s, declenche).
    - button_sniffer : diagnostic de l'appui (trames 0x5BF, écart entre trames,
    durée de l'appui, codes vus, micro-relâchements).
    - /api/status -> "ok_diag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
2026-10-25 v4.8.1 — textes d'aide (effacement OBD générique) ; v4.8.0 marquée STABLE
    - v4.8.0 validée en voiture le 2026-10-25 (release GitHub, tag 4.8.0 sur
    8e49c7f) : nouveau point de retour stable ; v4.6.0 devient la stable
    précédente.
    - Textes d'aide cellulaire + PC (visuels validés) : l'effacement des codes est
    un effacement OBD générique (moteur, et codes antipollution de la boîte DSG) ;
    « Refus ? Essayer moteur arrêté, contact mis ». Fenêtres de confirmation
    alignées.
    - Version 4.8.1 (seuls les textes changent par rapport à la v4.8.0).
    - Docs : README, ÉTAT_DU_PROJET, CLAUDE.md, guide Haldex.
    Claude-Session: h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
